YamamotoWorksDev/STM32H7S3_Dev_Board_v2/JUMBLEQ_mainboard_revD_review.md

# JUMBLEQ メインボード rev.D 回路図レビュー

レビュー日：2026-10-27

レビュワー：Codex

## レビュー対象と方法

- `JUMBLEQ_mainboard_revD_design.md`
- `STM32H7S3_Dev_Board.kicad_sch` および階層シート `mcu.kicad_sch`、`dsp.kicad_sch`、`power.kicad_sch`、`usb.kicad_sch`
- KiCadから出力したネットリストと設計書の照合、ERC、関連データシートの確認

回路図・設計書の修正は行っていない。本書はレビュー結果であり、Implementation Planではない。

## 指摘事項

### 1. ［重要］過電圧遮断設定が後段部品の絶対最大定格を超えている

**対象：** `power.kicad_sch` のU12（TPS2121）、R34～R37、および `usb.kicad_sch` のU13（STMPS2141STR）。

OV1・OV2の分圧抵抗23.7kΩ／4.99kΩは、標準しきい値1.06Vに対して約6.09Vで遮断する設定になっている。一方、5V_SYSに直結するU13の入力は、推奨動作上限5.5V、絶対最大6.0Vである。

標準値だけでも遮断前に絶対最大定格へ達し、さらにTPS2121のしきい値と抵抗のばらつきが加わるため、この設定ではU13の過電圧保護を保証できない。

**対応方針：** 正常な5V電源の最大電圧、しきい値・抵抗の誤差、遮断応答中の過渡電圧を含めてOV1・OV2を再設定する。許容範囲が成立しない場合は、後段部品または保護方式を見直す。

**根拠：** [TPS2121データシート](https://www.ti.com/lit/ds/symlink/tps2121.pdf)、[STMPS2141データシート](https://www.st.com/resource/en/datasheet/stmps2151.pdf)。

### 2. ［重要］ホスト側VBUSに明示的な放電経路がない

**対象：** `usb.kicad_sch` のJ10、U13、C82・C83、HOST_VBUS。

HOST_VBUSには10µFのC82・C83（合計20µF）が接続されているが、放電抵抗や放電スイッチは見当たらない。STMPS2141のデータシートにも出力放電機能の記載がない。

機器を抜いてU13をオフにしても、残留電圧の低下を漏れ電流だけに依存する構成になっている。Type-CのSourceに要求される、切断後650ms以内のvSafe0V到達を保証できない。

**対応方針：** 放電抵抗、制御可能な放電回路、または出力放電機能を持つスイッチを検討する。容量・抵抗の誤差と接続負荷を含めて放電時間を確認し、実機では無負荷での切断・再接続時のVBUS波形を測定する。

**根拠：** [USB Type-C Cable and Connector Specification Release 2.4、Table 4-32（TI掲載）](https://e2e.ti.com/cfs-file/__key/communityserver-discussions-components-files/196/USB-Type_2D00_C-Spec-R2.4-_2D00_-October-2024.pdf)、[STMPS2141データシート](https://www.st.com/resource/en/datasheet/stmps2151.pdf)。

### 3. ［重要］TVSのクランプ電圧がTPS2121の絶対最大定格を上回る

**対象：** `usb.kicad_sch` のD9（SMAJ15A）、`power.kicad_sch` のU12、および設計書の「J7の入力保護」。

設計書に記載されたSMAJ15Aのクランプ電圧24.4Vは、TPS2121のIN1の絶対最大定格24Vを上回る。「ほぼ同じ」という理由では保護成立とは判断できず、配線による電圧上昇も考慮する必要がある。

TPS2121のOV1は後段への通電を止める機能であり、IN1端子自体に加わる過電圧を遮断するものではない。また、継続的な誤電圧入力では、TVSの許容損失・エネルギーも問題になる。

**対応方針：** 想定するサージ波形・電流と入力電源の条件を定義し、TVSのクランプ特性、配線、必要に応じた電流制限・遮断手段を含めて保護協調を見直す。継続的な誤電圧と短時間のサージは別々に確認する。

**根拠：** 設計書記載のSMAJ15A仕様、および [TPS2121データシートの絶対最大定格](https://www.ti.com/lit/ds/symlink/tps2121.pdf)。

### 4. ［要修正］bMaxPowerへ本体とコントローラーの合計電流をそのまま設定できない

**対象：** 設計書の「USBホストポート」末尾にあるbMaxPowerの方針。

設計書の想定では、本体300mA＋コントローラー500mA＝800mAになる。一方、USB 2.0のbMaxPowerは2mA単位の1バイトであり、800mAは表現できない。USB HS接続であっても、この点はUSB 2.0である。

**対応方針：** Type-CのCCで得られる1.5A／3Aの給電許可と、USB構成記述子による申告を分けて設計する。Default電源時は、実際に許可された電流から本体の消費分を差し引き、ホスト側給電の可否を判断する。記述子と給電制御の具体的な扱いは、採用するUSBスタックと適用規格に合わせて確定する。

**根拠：** [USBデバイス記述子の仕様例（EPSON技術マニュアル）](https://global.epson.com/products_and_drivers/semicon/pdf/id002129.pdf)。

## 設計書と回路図の不整合

| 対象 | 指摘 | 対応方針 |
| --- | --- | --- |
| 「ファームウェアへの影響」の「アプリ側はGPIOを変更する必要がない」 | SPI5をPM11～PM14からPF6～PF9へ移す方針と矛盾する | SPI5のGPIO初期化変更が必要なことを明記する |
| 「J7の入力保護」のQ4ゲート保護 | 設計書は保護用ツェナーを設けるとしているが、回路図にはR30だけでツェナーがない | ツェナーを追加するか、不要と判断した条件・根拠を設計書へ反映する。通常の5V動作だけを理由に故障と断定する指摘ではない |
| 冒頭の「外部コネクタの信号・ピン機能とも変更なし」 | J1の9番ピンはGNDからPA4へ変更されている | 互換性の例外を明記する。既存キャリアが9番ピンをGNDへ接続している場合、PA4もGNDへ固定されるため、接続先を確認する |

## 確認できた事項

- KiCad ERCを再実行し、エラー0件・警告9件だった。電源保護や放電時間など、上記指摘の成立性はERCでは確認できない。
- FLASH・PSRAMの信号接続は、設計書のXSPI1／XSPI2割当表と出力ネットリストで一致した。
- PSRAM U11のCE#はA3へ接続されていた。

## 未検証事項

- カスタムフットプリントの実寸・ランドパターン照合。
- PCBのBGA引き出し、XSPI配線、インピーダンス、リターンパス、電源・GND配置。
- レギュレータ、Q1、Q4などの実際の放熱性能。
- 全FLASH候補の互換性、電源シーケンス、高速動作。
- 実機でのUSB接続、放電、電源切替、PR_Swap、消費電流・温度測定。

本レビューは回路図接続と関連仕様の確認であり、製造・実機動作の承認を意味しない。

## 再レビュー（2026-10-27）

前回指摘を受けた設計修正について、初回レビュー時と修正後のネットリスト・部品値の差分、設計書の対応内容、変更に直接関係するデータシートを確認した。回路図・設計書の修正は行っていない。

前回の指摘は概ね反映されているが、5V_SYS側の過電圧保護には以下の残件がある。初回レビュー本文は履歴として保持し、修正後の状態は本節を参照する。

### 残件：［要修正］U14の過電圧を「瞬間だけ」とする根拠が成立していない

**対象：** 設計書「レビュー対応」の過電圧遮断に関する説明、および5V_SYSに接続されるU14（USBLC6-4SC6）・レギュレータ・J8。

設計書は、USBLC6-4SC6について「過電圧の瞬間に少し導通するだけで、TPS2121がすぐに遮断する」としている。しかし、TPS2121の遮断電圧が最大6.18Vになる個体では、例えば入力6.1Vが継続しても遮断されず、5V_SYS上のU14にも継続して加わる可能性がある。

USBLC6-4SC6のVBUS–GND間の降伏電圧は最小6V（試験電流1mA）である。したがって、その導通を短時間に限定できるという説明では保護成立を保証できない。これは必ず故障するという断定ではなく、現状の説明と仕様から連続印加時の安全性を確認できないという指摘である。

また、AP7361Cは入力の絶対最大定格が6.5Vでも、推奨動作上限は6.0Vである。6.18Vが絶対最大定格内であることだけでは、その状態での正常な電源出力を保証できない。

**対応方針：** U14とレギュレータ、J8の接続先を含め、5V_SYSに継続して現れ得る最大電圧に対する許容条件を確認する。必要に応じて、過電圧の遮断・クランプ構成または後段部品を見直す。遮断しきい値付近の継続入力と、過渡的な入力を分けて評価する。

**根拠：** [USBLC6-4SC6データシート Table 2](https://www.st.com/resource/en/datasheet/usblc6-4.pdf)、[AP7361Cデータシートの絶対最大定格・推奨動作条件](https://www.diodes.com/datasheet/download/AP7361C.pdf)。

### 前回指摘の対応状況

| 項目 | 再レビュー結果 |
| --- | --- |
| U13の過電圧耐性 | STMPS2141STRからTPS25200DRVRへの変更を確認。1=OUT、2=ILIM、3=FAULT、4=EN、5=GND、6=IN、7=GNDの接続を確認した。ただし5V_SYS全体の保護成立は上記残件の確認が必要 |
| U13の制御・電流制限 | ENのR33による10kΩプルダウン、FAULTのR44による3V3へのプルアップ、ILIMのR45（169kΩ）接続を確認 |
| ホスト側VBUSの放電 | TPS25200の内蔵放電機能で対応する方針は妥当。データシートの放電抵抗は標準480Ω、最大625Ω。実機での無負荷切断・再接続時のVBUS波形確認は必要 |
| TVSのクランプ電圧 | D9のSMAJ15AからSMAJ13Aへの変更を確認。想定するサージ条件での電圧・エネルギーと配線による上振れの確認は引き続き必要 |
| bMaxPower | 800mA相当の合計値をそのまま申告する説明が、500mAの申告とType-C電流通知による給電判断へ修正されていることを確認。USBスタック側の具体的な実装確認は未実施 |
| SPI5・J1の説明 | SPI5のGPIO変更、およびJ1の9番ピンの変更と既存キャリア接続時の注意が追記されたことを確認 |
| Q4ゲート保護の説明 | ツェナーを付けない設計意図が追記されたことを確認。想定サージにおけるTVSの保護成立確認は別途必要 |
| ERC | 修正後の回路図で再実行し、エラー0件・警告9件 |

TPS25200のピン配置・EN極性・放電機能は、[TIデータシート](https://www.ti.com/lit/ds/symlink/tps25200.pdf)で確認した。

### 製作前の確認事項と記載の更新漏れ

- **U13のフットプリント：** 割当済みのKiCad標準フットプリントの端子パッドは0.375×0.4mmで、TIのDRV0006A推奨ランド例の0.45×0.3mmと異なる。直ちに不適合とは断定しないが、端子位置・重なり、露出パッド、はんだマスク・ペーストを含めて照合する。設計書でも未照合事項として残されている。[TIランドパターン](https://www.ti.com/lit/ds/symlink/tps25200.pdf)
- **J8の接続先：** キャリア基板の部品の耐圧確認が未完了。5V_SYS側の保護評価に含める。別プロジェクトの変更は実施していない。
- **R33の説明：** 設計書「回路図作成での確定事項」の「R33（ENのプルアップ）」は、現在の回路に合わせて「プルダウン」へ修正する。
- **U5の型番：** 回路図上のU5はAP7361EA-33E-13、U6はAP7361C-18E-13であり、レビュー対応欄の「U5／U6（AP7361C）」と一致しない。使用する実部品の型番と説明を揃え、その型番の定格で確認する。

今回の再レビューは変更箇所と直接関連する範囲に限定した。PCBの実装・配線、実機の電源波形、温度、USB動作は未検証である。

## PCBレビュー：XSPI・USBの本配線（2026-10-28）

### 対象・確認方法

- 設計書 `JUMBLEQ_mainboard_revD_design.md` の「XSPI・USBの本配線」。確認した版の更新日時は2026-10-28 17:39:01。
- `STM32H7S3_Dev_Board.kicad_pcb`。確認した版の更新日時は2026-10-28 17:37:38。
- 配線・ビア・ネットクラス・カスタムルール、および本配線に伴うコンデンサと電源面の変更。
- 直前のBGA引き出し段階のバックアップとの比較、PCBからの経路・寸法の取得、KiCad DRCと回路図との整合性確認。
- 一時コピーでKiCadのゾーン塗りつぶしを実施し、電源面への接続とDRCを再確認。元のPCB・回路図・設計書は変更していない。

本節は会話で実施した本配線レビューと、その後のスクリーンショットに対する追加確認をまとめたもの。下記は確認時点の指摘であり、修正済みかどうかは修正後のPCBで再確認する。上の回路図レビューは過去の履歴として保持する。

### 総合判断

XSPI・USBデータ線の接続を確認し、新たな短絡・クリアランス違反は検出されなかった。XSPIの細線区間も前回の引き出し段階から短縮されている。

ただし、USBのインピーダンス条件の確認と、XSPIの鋭角の折り返しの修正が必要。本配線を確定する前に以下を反映し、長さ・間隔・ゾーン塗りつぶし後の接続を再確認する。

### 1. ［P2・要確認／修正］USB HSのコネクタ側にrev.Cの配線寸法が残っている

**対象：** U9（ECMF2-40A100N6）～J9、`/USB/D+`・`/USB/D-`。設計書のUSB HSの説明。

U2～U9は今回の寸法で配線されているが、U9～J9の表層約2.7mmには、幅0.2111mm・間隔約0.189mmの配線が残る。J9のA/B面のデータ端子を接続する内層配線にも、幅0.25mmなどの寸法が残っている。

rev.Dで計算したL1の90Ω差動条件は幅0.1753mm・間隔0.2032mmである。積層をJLC06161H-7628からJLC06161H-2116Aへ変更したため、rev.Cの配線を流用したことだけでは、rev.Dでのインピーダンスを確認したことにならない。

これは、その区間が必ず規格外になる、または通信不良になると断定する指摘ではない。実際の形状に対する計算と、許容範囲の確認が不足している。

**対応方針：** U9～J9を含む経路全体について、実際の層・線幅・間隔・参照面を今回の積層で再評価する。通常の並走区間は今回の90Ω条件へ合わせ、コネクタの引き出し・A/B端子の合流部分に生じる寸法の変化は短くする。評価結果と採用寸法を設計書に記載する。

### 2. ［P2・要確認／修正］USB FSを離して配線する条件が未評価

**対象：** U2～U14・J10、`/MCU/USB_FS_D+`・`/MCU/USB_FS_D-`。設計書の「12Mbpsのため、結合した差動にはしていません」の説明。

表層の約21mmの区間で、D+とD-の中心間隔が約3mmある。線幅は0.175mmだが、これは間隔0.2032mmと組み合わせて求めた差動配線の値であり、線幅だけを同じにしても90Ωの条件は維持されない。

Full Speedが12Mbpsであることだけでは、差動インピーダンスの設計目標を外す根拠にならない。ただし、離して配線すること自体を一律に不適合と断定するものではなく、弱く結合した線路としてのインピーダンス、許容範囲、経路の評価が必要である。

**対応方針：** 基本は、今回の積層で計算した90Ωの差動ペアとして配線し直す。離して配線する方針を維持する場合は、その形状での評価と許容判断の根拠を設計書に残す。長さの差だけで合否を判断しない。

### 3. ［P2・要修正］XSPIの3か所に内角45度の折り返しがある

**対象：** 以下の配線。座標はKiCad基板座標、単位mm。

| ネット | 層 | 折り返しの頂点（x, y） | 確認内容 |
| --- | --- | --- | --- |
| PSRAM_IO6 | F.Cu | (127.75, 82.50) | U11のE2付近。内角45度の折り返し |
| FLASH_IO7 | F.Cu | (123.55, 100.25) | U1のE1からの経路。内角45度の折り返し |
| FLASH_IO3 | In2.Cu | (121.80, 92.75) | 同様の内角45度の折り返し |

問題は線が45度以外の方向に伸びていることではなく、経路が大きく折り返して鋭いくさび状の隙間を作ることである。水平・垂直・45度の線だけでも、この形状は生じる。

製造できない、または必ず断線すると断定するものではないが、鋭角部はエッチング時の過剰な侵食などの要因となるため避ける。信号品質についても、局所的なインピーダンス変化や近接部分同士の結合を増やす不要な形状である。実際の影響量は未測定。

**対応方針：** 鋭い折り返しをなくし、通常の45度曲がり（内角135度）や緩やかな経路へ変更する。長さ合わせのための迂回も含むため、単純に近道へ変更して完了にせず、必要な長さは余裕のある場所で間隔を確保した蛇行に置き換える。修正後はデータ群の長さの差を再確認する。

**追加確認による訂正：** 当初の本配線レビューでは、この3か所の折り返しを見落としていた。スクリーンショットの提示を受けてボード上で確認し、追加指摘とした。以前の「45度以外の方向の直線は角度だけを理由に描き直す必要はない」という判断とは区別する。

### 4. ［改善推奨］USB HS D+の細かい直角ミアンダを整理する

**対象：** `/MCU/USB_HS_D+`、F.Cu、x約130.9701～131.2115、y約103.50～104.55。

線幅は0.175mm、蛇行の隣り合う部分の中心間隔は0.35mmで、銅箔間の隙間は約0.175mmある。直角だけを理由に製造不良や通信不良になるとは判断しない。前項の内角45度の鋭角とは区別する。

ただし、細かい蛇行によってD-との間隔が局所的に変化し、蛇行した配線の部分同士も近接している。配線長の増加量が、そのまま電気的な遅延の増加になるとは限らない。現在のミアンダで追加している中心線の長さは約0.97mmである。

**対応方針：** 必要なスキュー補正量を確認し、45度の斜線や円弧を使った余裕のある形状へ整理する。長さの完全一致だけを目的に細かく刻まない。角を変更するだけでなく、差動ペアの間隔と、蛇行の近接部分同士の間隔も確認する。形状変更後に長さとDRCを再確認する。

### 5. ［改善推奨］U1の100nFコンデンサの近接配置を再検討する

**対象：** U1の1V8用C4・C21、およびC3・C20の移動。

U1～U2の配線経路を確保するため、C3・C4・C20・C21はU1の北側の裏面へ移動している。従来の担当ボールから100nFコンデンサの電源パッドまでの平面上の直線距離は、E4～C4で約4.8mm、D1～C21で約7.3mmになった。これらは実際の電流経路やループ長の測定値ではない。

ゾーン塗りつぶし後に電源面への接続は確認できたが、接続の有無だけで高周波のデカップリング性能を確認したことにはならない。

**対応方針：** 4.7µFのバルクとは分けて、100nFのC4・C21だけでも担当電源ボールの近くへ戻せる配置を検討する。位置だけでなく、電源・GNDの両方の経路を短く保つ。

### 6. ［改善推奨］U14・R44のパッド端を通る配線を整理する

**追記日：** 2026-10-28。ユーザーが緑線で囲ったスクリーンショットと、同じ版のPCBを照合した。

**対象：** U14（USBLC6-4SC6）の1・3番パッド、およびR44（10kΩ、0201サイズ）の2番パッド。いずれもF.Cu。

| 箇所 | 確認した形状 | 対応方針 |
| --- | --- | --- |
| U14・1番：USB_FS_D+ | 幅0.175mmの配線がパッドの上辺に沿って通過する | 辺へ直角に接続して十分に重ね、曲がりはパッドとマスク開口から離れた位置に設ける |
| U14・3番：USB_FS_D- | 幅0.175mmの配線が左上の角付近から斜めにパッドを横切る | 基本は辺へ直角に接続する。斜め接続が必要なら、角の方向から十分に重ね、鋭い隙間を残さない |
| R44・2番：HOST_VBUS_FLT | 幅0.18mmの配線がパッドの右上部分をかすめて通過する | 主配線から短く分岐するなどして辺へ直角に接続し、両端の熱バランスも確認する |

現在も配線とパッドの銅箔は重なっており、パッドそのものが欠けているわけではない。斜めに入っていることだけを理由に、はんだ不良が生じるとは断定しない。製造前に整理したい接続形状の改善事項として扱う。

**接続方針の補足・訂正（2026-10-28）：**

PSRAM_CSのパッドへ辺の途中から斜めに接続した追加スクリーンショットを受け、接続方針を以下のように明確化する。従来の「パッド中央付近へ接続する」という説明だけでは、斜めの線をそのまま辺の中央へ入れる形状を勧めるように読めるため不十分だった。上表もこの方針に合わせて更新した。

1. **基本は辺へ直角に接続する。** パッド付近に短い直線部分を設け、パッドとマスク開口から離れた位置で45度に曲げる。接続・引き出しの両方に適用する。
2. **斜めのまま接続する必要がある場合は、辺の途中に鋭角を作るより、角の方向から入れて十分に重ねる。** 角をかすめるだけの接触や細い接続部分を避け、銅箔の輪郭に鋭いくさび状の隙間を残さない。丸みのあるパッドも、実際の銅箔形状で確認する。
3. **小型2端子部品は両端の条件を確認する。** 進入方向だけでなく、配線幅・本数・接続銅箔量・ビアとの距離を比較する。

角からの接続を選ぶ理由は、鋭角をなくすための形状上の改善である。角から接続すれば実装不良を防げる、という一律の保証ではない。

また、基板製造時のエッチング液の残留と、実装時のフラックス・はんだの挙動は別の現象として評価する。鋭角部のエッチング上の懸念と、チップ立ちにつながる両端の加熱・ぬれの不均衡を混同しない。「角度の小さい側に液が残ることがチップ立ちの直接原因である」とまでは、画像や導通確認から断定できない。

**実装品質での確認事項：**

- 銅箔の表示に加え、はんだマスクの開口とペーストの開口を確認する。マスク開口によって接続配線まで露出すると、はんだが配線側へ広がる可能性がある。隣接パッドとのマスクの仕切りも含めて確認する。
- R44は小型の2端子部品であるため、反対側の3V3配線も完成した段階で、両端の配線幅・銅箔量・ビアへの接続を比較する。チップ立ちの主な確認対象は両端の加熱・ぬれの不均衡であり、斜め配線そのものを原因と断定しない。3V3側は今回の確認時点では未配線のため、最終的な熱バランスは未評価。
- U14はESD保護部品なので、信号線から保護端子までの接続を短く保つ。形状を整えるために長い分岐配線を追加しない。GNDへの接続も短くする。

**修正後の確認：** 辺への進入角度とパッド内への十分な銅箔の重なり、鋭いくさび状の隙間の有無、マスク・ペーストの開口、隣接導体との間隔、USB FSの経路と長さを確認し、DRCを再実行する。既存の導通・クリアランス確認だけで、実装時のはんだ形状や熱バランスまで検証済みとはしない。

### 設計書の記載修正

- PSRAM_IO3にはビアが4個ある。「PSRAMのデータは、ほぼIn2だけで配線しました（ビアは両端に1個ずつ）」には、この例外と実際の経路を追記する。
- USBの流用区間とFSの配線方針は、上記の評価・修正結果を反映する。
- 鋭角部やミアンダを変更した後は、長さの集計表も更新する。

### 確認できた事項

| 項目 | 確認結果 |
| --- | --- |
| XSPI・USBデータ線 | 未接続なし |
| XSPIのデータ群の長さの差 | 独立した経路集計でもPSRAM約4.7mm、FLASH約9.3mmで、設計書の設定範囲内。集計方法による小差を含む概数 |
| XSPIの幅0.10mmの区間 | 最長約1.77mmまで短縮。前回の引き出し段階の最長約7.47mmから改善 |
| USB HSのU2～U9 | D+・D-とも約28.70mm |
| 保存済みPCBのDRC | 違反450件＋未配線489件＝939件。回路図との不一致0件 |
| 一時コピーでのゾーン塗りつぶし後 | 違反372件＋未配線358件＝730件。片側だけにつながるビアの警告79件が解消 |
| BGAの電源 | 塗りつぶし後、U2・U1・U11・U10の電源・GNDについて未接続は検出されなかった |
| 新たな短絡・クリアランス違反 | 検出されなかった |

塗りつぶし後の違反372件の内訳は、シルク関係288件、XSPI・USB以外の引き出しの開放端75件、既存のJ9・J10の穴クリアランス4件、既存のライブラリとの不一致4件、DSP用DVDD面の孤立銅箔1件。DSP用DVDD面は今回の信号配線とは別の残件である。

上記の接続・長さ・DRCの結果は、角度やインピーダンスなどの指摘を解消したことを意味しない。また、後続の配線や配置変更に伴い、再確認が必要となる。

### 修正後の確認事項

1. XSPIの鋭角3か所を修正し、データ群の長さの差を再集計する。
2. USB HSをU2～U9～J9の全経路で確認し、流用区間のインピーダンス条件を更新する。
3. USB FSの配線形状とインピーダンス条件を整合させる。
4. USB HSのミアンダ、U1の100nFコンデンサの改善を検討し、採用した形状・配置を設計書へ反映する。
5. U14の1・3番とR44の2番のパッド接続形状を、辺へ直角に接続することを基本として整理する。追加画像のPSRAM_CSも同じ方針を適用し、斜め接続時には鋭角を残さない。マスク・ペーストの開口、および小型2端子部品の両端の配線後の熱バランスも確認する。
6. ゾーンを塗りつぶしてDRCと回路図との整合性を再確認する。残りの配線を進めても、GND参照面と電源面の接続を維持する。

実機でのUSB通信、XSPI 200MHz DDR動作、信号波形・アイパターン、電源品質は未検証。電磁界解析や信号品質シミュレーションは実施していない。本節は今回の配線範囲のレビューであり、製造データや実機動作の承認ではない。

### 根拠資料

- [ST AN5935：Getting started with STM32H7Rx/7Sx MCUs hardware development](https://www.st.com/resource/en/application_note/an5935-getting-started-with-stm32h7rx7sx-mcus-hardware-development-stmicroelectronics.pdf)：10.4.3のXSPI配線条件。
- [JLCPCB Impedance Calculator公式ガイド](https://jlcpcb.com/help/article/user-guide-to-the-jlcpcb-impedance-calculator)：積層・線幅・間隔・参照面を組み合わせた計算条件。
- [TI SLLA414A：High-Speed Layout Guidelines for Signal Conditioners and USB Hubs](https://www.ti.com/lit/an/slla414a/slla414a.pdf)：USB 2.0のインピーダンス目標、差動ペアの対称性、曲がり方。
- [TI SPMA056：System Design Guidelines for the TM4C129x Family](https://www.ti.com/lit/an/spma056/spma056.pdf)：3.3.4の直角配線と鋭角部に関する説明。一般的な配線形状の参考資料として参照。
- [JLCPCB：Basic Design of Solder Mask](https://jlcpcb.com/blog/basic-design-of-solder-mask)：マスク開口と、接続配線に広がるはんだの関係。
- [Eurocircuits：Tombstoning](https://www.eurocircuits.com/technical-guidelines/pcb-assembly-guidelines/tombstoning/)：小型2端子部品の加熱・ぬれの不均衡とチップ立ち。
- [ST USBLC6-4データシート](https://www.st.com/resource/en/datasheet/usblc6-4.pdf)：2.3のESD保護用配線を短くする指針。
- [EMA Design Automation：Top DFM Issues to Check and Avoid During PCB Layout](https://www.ema-eda.com/ema-resources/blog/top-dfm-issues-to-check-and-avoid-during-pcb-layout/)：鋭角部とエッチング時の液残留に関する説明。実装時のチップ立ちとは分けて参照。

## 追加レビュー：U10のパッド内ビアと配線端点（2026-10-29）

対象は、追加画像と保存済みPCB（更新日時：2026-10-28 20:16:16）のU10周辺。前回レビューではU10のパッド内ビアを見落としていたため、追加の修正事項として記録する。U10は現在DNPだが、実装オプションとして使用する場合の製造・実装条件を整える必要がある。

### 1. 要修正：U10の5か所のパッド内ビア（U10実装時）

U10は裏面のSOIC-8で、FLASH_IO0/1に加え、FLASH_CS、GND、1V8にもパッド内ビアがある。該当ビアはいずれも外径0.45mm、穴径0.20mm。以下の座標はPCB上の絶対座標で、単位はmm。

| ピン | ネット | パッド中心（X, Y） | ビア中心（X, Y） |
| --- | --- | --- | --- |
| 1 | FLASH_CS | 120.405, 100.5875 | 120.4, 100.1 |
| 2 | FLASH_IO1 | 119.135, 100.5875 | 119.4, 99.9 |
| 4 | GND | 116.595, 100.5875 | 116.6, 100.6 |
| 5 | FLASH_IO0 | 116.595, 93.4125 | 116.9, 93.6 |
| 8 | 1V8 | 120.405, 93.4125 | 120.4, 93.4 |

FLASH_IO0/1は特にパッドの側端近くにビアがあり、穴がパッドの開口に重なる形状になっている。実装時には、はんだがビア穴へ吸い込まれ、端子下のはんだ量が不足する懸念がある。ここで主に確認すべき不良はSOIC端子のはんだ不足・接合不良であり、小型2端子部品のチップ立ちとは区別する。

現行PCBの設定は表裏の通常のテンティングが有効で、充填・銅キャップの指定はない。発注時の加工条件は未確認であり、PCBの設定だけではFilled & Cappedによる平坦な実装面を保証できない。通常のテンティングだけでパッド内ビアの問題が解消したとは判断しない。

修正方針は次のいずれかとする。

- ビアをパッド外へ移し、実際のソルダーマスク開口間に分離を確保して、短い配線で接続する。ビア穴がパッドから少し外れるだけでは、開口の重なりが残る可能性がある。
- パッド内ビアを残す場合は、JLCPCBでのFilled & Cappedの適用範囲と加工条件を確定し、製造データおよび発注仕様に反映する。

**ビアをパッド中央へ移すだけでは、はんだの吸い込み対策にならない。** 配線をビア中心へ接続するルールと、実装パッド内にビアを置いてよいかという判断は別に扱う。

### 2. 改善：U10の配線端点をパッド中心へ統一する

3番FLASH_IO2、6番FLASH_CLK、7番FLASH_IO3の裏面配線端点は、パッド中心まで届かず、端部または角付近で止まっている。採用済みの配線ルールに合わせ、端点をパッド中心へそろえる。辺から入る場合は直角に接続し、斜めに入る場合は角から接続して鋭角のくぼみを残さない。

ただし、**既に配線の銅箔がパッドへ十分に重なっている場合、パッド内だけ端点を延長しても、製造される銅箔形状は通常変わらない。** 「中心まで届いていない」ことだけを断線や実装不良の根拠にはしない。実装品質については、パッド外の接続形状、ビア穴、ソルダーマスク・ペースト開口を確認する。

### 修正後の確認事項

1. 1・2・4・5・8番のビアについて、パッド外への移動とマスク開口の分離、またはFilled & Cappedの製造条件確定を確認する。
2. 3・6・7番を含むU10の配線端点と、パッドへの進入形状を確認する。ビアへの配線はビア中心へ接続し、パッド外に直角の折れ曲がりや鋭角のくぼみを残さない。
3. U1/U10の排他実装構成、XSPIの配線長・分岐長・参照面を維持し、ビア移動による不要な引き回し増加を避ける。
4. ゾーンを再充填してDRCを確認し、製造データで実装面のパッド開口・ビア穴・マスク分離を確認する。U10を実装する場合は、試作時のはんだ接合状態も確認する。

今回の追記ではPCBデータを変更しておらず、DRCも再実行していない。過去の節に記載したDRC件数は、それぞれの確認時点の結果として扱う。

### 根拠資料

- [JLCPCB：Via-in-Pad (POFV) Guide](https://jlcpcb.com/help/article/via-in-pad-pofv-guide)：パッド内ビアによるはんだの吸い込みと、充填・キャップ処理。
- [JLCPCB：PCB Via Covering](https://jlcpcb.com/help/article/pcb-via-covering)：テンティングとFilled & Cappedの加工方法の違い。

## PCBレビュー：配線完了後の全体確認（2026-11-05）

レビュワー：Claude

### 対象・確認方法

- `STM32H7S3_Dev_Board.kicad_pcb`。確認した版の更新日時は2026-11-04 21:07:47（KiCadで開いている最中のため、保存済みの版を対象とした）。
- `JUMBLEQ_mainboard_revD_design.md`（更新日時2026-11-04 21:12:34）と、本書の過去の指摘。
- KiCad 10.0.7でDRC・ERC、回路図とフットプリントの照合を実行した。
- PCBファイルから配線・ビア・パッド・ゾーンの塗りつぶし形状を読み出し、次を集計した。
  - 全信号配線の参照GND面（F.Cu・In2→In1、B.Cu→In4）
  - F.Cu／In2とB.Cuの間で層を切り替える箇所から最寄りのGNDビアまでの距離
  - クロック線と隣接配線の間隔・並走長
  - XSPI・USB・SDMMC・SAIの配線長
  - 内角90度未満の鋭角と、配線途中の90度の曲がり
  - パッドとビアの間隔、シルク
- PCB・回路図・設計書は変更していない。長さは特記がない限りビアの層間距離を含まない平面上の中心線長、座標はKiCadの基板座標（mm）である。
- 確認用の図は `.work/review-20261105/` に置いた（`sai_in.png`：SAI 3本の経路、`silk_front.png`：表面シルクと基板直置きのシルク線）。

### 総合判断

未配線は0件で、回路図との不一致もない。DRCに残る175件は、シルク168件、J9・J10の穴クリアランス4件、ライブラリとの差分3件で、短絡やクリアランス違反はない。内層のGND面・電源面は連続しており、信号配線の参照GND面に、アンチパッド以外の切れ目は見つからなかった。XSPI・USB・SDMMCは、設計書の値と条件を満たしている。

一方で、11/04の残配線に伴って、MCU→DSPのSAI（SAI2）が大きく迂回している。また、シルクにrev.Cの表記・枠・ラベルが残っている。製造データを作る前に、下記の1〜4への対応を勧める。

### 1. ［P2・要修正］MCU→DSPのSAI 3本が大きく迂回し、直列抵抗が受信側にある

**対象：** `/DSP/DSP_BCLK_IN0`（U2.P14→R13）、`/DSP/DSP_LRCLK_IN0`（U2.N13→R15）、`/DSP/DSP_SDATA_IN0`（U2.M12→R18）。

| 信号 | U2→直列抵抗の長さ | 信号ビア | F.Cu／In2⇔B.Cuの切替（参照面がIn1⇔In4に変わる） | 11/04の変更前（設計書） |
| --- | ---: | ---: | --- | --- |
| BCLK_IN0 | 73.26mm | 8個 | 6か所。うち4か所は最寄りGNDビアまで3.19〜4.46mm | 34.04mm／3個 |
| LRCLK_IN0 | 59.95mm | 5個 | 2か所（最寄りGNDビアまで0.70mm） | 59.95mm／5個 |
| SDATA_IN0 | 70.11mm | 12個 | 8か所。最寄りGNDビアまで0.61〜2.94mm（1mm超が6か所） | 36.83mm／3個 |

3本は、BGAの左上（127〜129, 90〜92付近）から出ている。BCLKはJ2近く（x≈105）まで西へ、SDATAはU11の北（y≈80）を回ってx≈155まで東へ出てから、U3の手前のR13・R15・R18（x≈140.4, y≈108.8〜110.4）へ戻っている（`sai_in.png`）。U2のボールから抵抗までの直線距離は約22mmである。

- **直列抵抗の位置：** R13・R15・R18は、U3のピンから約1.6〜1.9mmの位置にある。SDATA_IN0はMCUのSAI2A\_DATA\_OUTが駆動するので、R18は受信端にあり、ダンピング抵抗として働かない。MCUがSAI2のクロックマスターであれば、BCLK・LRCLKのR13・R15も同じ状態になる。DSP→MCU側のR14・R16・R19は、駆動側のU3の近くにあり、問題ない。
- **長さと配線形状：** 約70mmの線長は、STM32のGPIOを高速設定にしたときの立ち上がり時間に対して、反射を無視できる長さではない。そこに反射・リンギングを抑える抵抗がない状態である。BCLKが1回でも二重にクロックされると、音声データのずれとして現れる。さらにBCLKは、参照面の切替点の近くにGNDビアが少ない。
- **隣接配線：** BCLK_IN0は、裏面のy≈107.4〜107.8・x 110.7〜124.3で、J2向けのI2S3\_SDIと約13.7mm、銅箔間隔0.22mmで並走している。

これは、必ず誤動作すると断定する指摘ではない。反射・クロストークの量は計算・測定していない。ただし11/04の変更でBCLK・SDATAの線長が約2倍、ビアが3〜4倍になっており、DRCでは検出されない劣化である。

**対応方針：**

1. 3本を短い経路へ引き直す。目安は変更前の35mm前後。裏面を通す場合は、F.Cu⇔B.Cuの切替点から1mm程度以内にGNDビアを置く。I2S3\_SDIとの並走は、なくすか、間隔を線幅の3倍以上にする。
2. 経路を大きく変えられない場合は、MCUが駆動する信号の直列抵抗をU2の近くへ移す。SDATA_IN0は必須、BCLK・LRCLKはMCUがマスターの場合に移す。
3. ファームウェアでは、SAI2のGPIO速度を必要最小限（LowまたはMedium）に設定する。
4. 試作では、U3のピン側でBCLK_IN0の波形（オーバーシュート・リンギング・階段状の部分）を確認する。

### 2. ［P2・要修正］シルクにrev.Cの版表記・枠・ラベルが残っている

| 内容 | 位置・状態 |
| --- | --- |
| 版・日付 | 表面に「rev.C」（154.5, 94.8）と「2025/07/02」（148.4, 96.4）が残る |
| 旧配置の枠 | 基板に直接置かれたシルク線148本の多くが、rev.Cの部品配置に合わせた枠（`silk_front.png`の赤線）。U11（PSRAM）のボールパッドD3〜D5・E3・A5の上を横切る線（例：(129.85, 80.25)→(134.4, 80.25)）や、U5・U1・U12周辺と重なる線がある |
| USBコネクタのラベル | J9・J10の間の「MCU」（132.2, 129.1）と「DSP」（138.6, 129.1）、J10下の「USBi」（149.1, 136.1）。rev.DのJ10はMIDIコントローラー用のUSBホストで、DSP（USBi）用ではない |
| DRC | シルク関係168件：パッドとの重なり72件、シルク同士の重なり92件、基板端4件 |

パッドに重なったシルクは、通常は基板メーカーが削るので、はんだ付けへの影響は小さい。ただしβ版を他の人が使う基板で、版表記とコネクタのラベルが実態と違うと、取り違えの原因になる。

**対応方針：**

- 版表記を「rev.D」と発行日に更新する。
- 旧配置の枠を削除するか、現在の配置に合わせて描き直す。
- J9を「PC」「DEVICE」など、J10を「HOST」「MIDI」などに改める。
- そのうえで、シルク関係のDRCを、基板端（コネクタのはみ出し）以外は解消する。

### 3. ［要修正・軽微］11/04の変更で、パッドに近すぎるビアが2か所できている

設計書の配線ルール「実装パッドの中にビアを置かない。新しく置くビアは、パッドの銅箔との間を0.15mm以上空ける」に反する。

| 部品・パッド | ビア（外径／穴径） | 状態 | 経緯 |
| --- | --- | --- | --- |
| C28・2番（1V8、裏面0201） | (128.40, 93.80)、0.45／0.20mm | ビアの銅箔がパッドに約0.05mm重なる（穴はパッドの外） | 11/04にC28を(128.150, 93.085)・270°へ移動 |
| R3・1番（1V8、表面0201） | (112.38, 96.08)、0.60／0.30mm | パッドとの間隔約0.02mm | 11/04にR3を移動し、1V8ビアを移動 |

マスク開口とテンティングの境目にビアがかかり、0201の片側だけにはんだが流れる原因になり得る。ビアをパッドの外へ0.15mm以上離し、短い配線で接続する。

### 4. ［製造前確認］発注仕様・部品の確定

- **表面処理：** PCBの設定は「None」。0.8mmピッチのBGAと0201を実装するので、ENIGを指定する。JLCPCBも、平坦性の点からBGA・狭ピッチ部品にはHASLよりENIGが適しているとしている。
- **フィデューシャル：** 基板上にはない。JLCPCBのStandard PCBAでは、エッジレールとフィデューシャルが必要である。両面実装なので、発注時に表裏とも付けるようにする。基板内に3点置く方法でもよい。
- **J9・J10の穴クリアランス（DRCエラー4件）：** 10/29から未決定のまま。NPTHとGNDパッドの間隔は0.1651mm（設定0.20mm）。フットプリントの調整か、メーカーへの確認で扱いを決める。
- **J7の型番：** 設計書は「S2B-XH-A（横向き）」だが、フットプリントはJST\_XH\_B2B-XH-A\_1x02\_P2.50mm\_Vertical（縦型）。どちらを実装するかを決め、横向きにするならフットプリントと向き（差込口の方向、基板端との関係）を合わせる。
- **U3（ADAU1466）の露出パッド：** 5.3mm角のパッド73自体にペースト層がある。そのため、フットプリント内の窓状のペースト16個（約72%）と合わせて、実質100%の塗布になる。パッド内には0.6／0.3mmのGNDビアが9個あり、穴が開いたままである。U7（TCPP03）の露出パッドも、2.2mm角にビア5個で全面ペーストである。パッド73のペースト層を外して窓状の開口だけにし、ビアを窓の間に置くか穴埋めを指定するかを決める。rev.Cで同じ構成の実績がある場合は、その結果で判断してよい。

### 5. ［改善推奨］クロック・アナログ入力の近接並走

DRCの間隔は満たしているが、次の並走を広げられる場所では広げる。表の間隔は銅箔端の間隔。

| 組み合わせ | 層 | 並走長 | 間隔 | 位置 |
| --- | --- | ---: | ---: | --- |
| CLKOUT（DSP→MCU・J5）とSDATA_OUT2 | In2 | 約7.1mm | 0.133mm | (145.5, 108.8)→(150.5, 113.8)の斜め区間 |
| BCLK_OUT1とLRCLK_OUT2 | In2 | 約4mm | 0.139mm | U3北東、(148.5, 109.4)→(151.0, 112.3)付近 |
| BCLK_OUT2とSDATA_OUT1 | B.Cu | 約2.3mm | 0.139mm | (146.0〜147.4, 108.8〜110.2) |
| ETH_RMII_REF_CLK（50MHz）とADC1_IN0 | In2 | 約6mm | 0.34mm | (140.7, 83.3)→(144.9, 79.1) |
| SDMMC2_CKとADC1_IN18 | In2 | 約3.6mm | 0.169mm | (135.5, 88.7)→(136.8, 85.8)。BGA引き出しの出口 |
| HSE_IN（24MHz）とADC1_IN12 | F.Cu | 約2mm | 0.22mm | (137.6〜139.6, 93.4)。BGA引き出しの出口 |

ADC入力は、入力源とフィルタが未確定である。クロックの結合がADC精度にどれだけ影響するかは、実機で確認する。

### 6. ［改善］配線形状の残り

設計書の配線ルールに対する残りで、電気的な影響は小さい。

- **配線途中の90度の曲がり（8か所）：**
  - LPUART1_RTS（B.Cu）：(114.904, 104.304)、(120.585, 104.8)、(122.28, 104.8)
  - ADC1_IN13（In2）：(136.4, 92.2)
  - ADC2_IN2（F.Cu）：(131.2, 74.9)
  - FDCAN2_RX（In2）：(125.85, 92.65)
  - LPUART1_TX（In2）：(134.15, 101.75)
  - ETH_RMII_CRS_DV（F.Cu）：(154.556, 84.819)
- **内角45度の折り返し：** FDCAN2_RX（In2）の(125.0, 91.8)。(125.85, 92.65)から来て、東へ折り返している。
- **T分岐の45度のくさび：**
  - FLASH_IO1（In2）：(121.55, 98.4)。U10への分岐
  - I2C2_SCL（In2）：(129.2, 101.8)
  - I2C2_SDA（F.Cu）：(124.6, 103.1)
- **重複・微小な配線片：**
  - FLASH_IO1（In2）：(127.6, 96.2)→(127.6, 96.4)が2本重複
  - GND（B.Cu）：(126.92, 92.32)と(128.635, 92.765)の周辺に重複区間
  - CLKOUT（In2）：(150.49〜150.55, 113.8)の0.06mmの折り返し
  - NRST（F.Cu）：(156.748, 134.439)の0.07mmの枝
  - FLASH_IO0（In2）：(118.53, 95.22)の0.01mmの枝

### 7. ［要確認］Q1（FZT953）の放熱

コレクタ（DVDD）の銅箔は、表面約24mm²、裏面約35mm²、In3のDVDD島約145mm²である。タブから裏面・内層へのビアは(153.6, 123.5)と(153.6, 124.3)の2個だけである。設計書の熱抵抗78℃/Wは、25×25mm（625mm²）・1ozの条件の値である。標準的なプログラム（約0.46W）では問題になりにくい。一方、最大負荷の見積もり（約1.04W）では、接合部温度の余裕がない可能性がある。タブの銅箔内に放熱ビアを数個追加し、試作基板でDVDD電流とQ1の温度を測る（設計書の未完了項目と同じ）。

### 前回までの指摘の対応状況

| 指摘 | 現在の状態 |
| --- | --- |
| 回路図1：OV設定 | R34・R36＝21.5kΩをPCBで確認。5.28V付近での誤遮断を許容する方針は設計書どおり |
| 回路図2：ホスト側VBUSの放電 | U13＝TPS25200DRVR、専用フットプリント（DRV0006A）を確認 |
| 回路図3：TVS | D9＝SMAJ13Aを確認 |
| 再レビュー：U14の過電圧 | U14の5番（VBUS）が3V3に接続されていることを確認 |
| 再レビュー：J8の先の耐圧 | 未確認のまま（キャリア側） |
| PCB1：USB HSのU9〜J9 | 0.175mm／間隔約0.203mm、In2は0.164mmで配線し直し済み。U9→J9はA側4.06／4.06mm、B側5.78／5.78mm |
| PCB2：USB FS | ペアとして配線済み。U14周辺の約5mmは非並走（設計書記載どおり）。U2→J10のA6／A7は39.58／39.95mm |
| PCB3：XSPIの鋭角 | XSPIの折り返しは解消。FLASH_IO1のU10分岐に45度のくさびが1か所ある（上記6） |
| PCB4：USB HSのミアンダ | 台形4つへの変更を確認。U2→U9はD+・D−とも28.70mm |
| PCB5：U1の100nF | C4・C21が担当ボールの近くにあることを確認 |
| PCB6：U14・R44のパッド接続 | 設計書の対応内容を確認。形状の詳細は今回再確認していない |
| U10のパッド内ビア | U10のパッドに重なるビアはない |
| C75のDNP不一致 | PCB・回路図とも実装扱いで一致 |

### 確認できた事項

| 項目 | 結果 |
| --- | --- |
| DRC（KiCad 10.0.7） | 175件（シルク168、穴クリアランス4、ライブラリ差分3）。未配線0、回路図との不一致0 |
| ERC | 除外を除き警告9件（rev.Cから引き継いだもの。以前と同じ件数） |
| 回路図とフットプリント | 174個で一致 |
| 内層の面 | In1／In4のGND面、In3の3V3面と各島（1V8・DVDD・5V_SYS・5V_UCPD・5V_IN）は、それぞれ1つの連続した銅箔 |
| 参照GND面 | 信号配線は、ビア・穴のアンチパッド以外では途切れなく参照面の上を通る。U2下でアンチパッド同士がつながった部分を通る区間は、最長0.72mm（I2S3_WS、B.Cu）で、BGA引き出しの範囲内 |
| XSPI | データ群（DQS・IO0〜7）の長さの差：PSRAM 4.12mm、FLASH 6.15mm（ビアの層間距離を加えると設計書の約9.2mm）。CLKの蛇行なし。U10への分岐は、主経路の分岐点から2.0〜5.5mm |
| SDMMC2 | CK・CMD・D0〜D3は設計書の値と一致（58.26〜66.40mm、D0〜D3のビア各4個） |
| USB HS | 主並走区間の銅箔間隔は0.202〜0.215mm |
| パッド内ビア | 露出パッドの放熱ビア（U3・U7・U13）とC28以外にはない |

### 未検証事項

- 反射・クロストーク・PDNの数値解析と、電磁界シミュレーション。
- 実機でのSAI・SDMMC・Ethernet・USB・XSPIの波形とタイミング、ADC精度、Q1・U5・U6の温度。
- J9・J10・J7の実物の寸法と、筐体・キャリアとの干渉。
- 裏面シルクの内容（今回は表面を中心に確認した）。

本節は配線完了時点のPCBのレビューであり、製造データや実機動作の承認ではない。

### 根拠資料

- [JLCPCB：Surface Finish](https://jlcpcb.com/help/article/jlcpcb-surface-finish)：HASLは平坦性が必要なBGAなどに向かず、ENIGが適している。
- [JLCPCB：How to add edge rails/fiducials for PCB assembly order](https://jlcpcb.com/help/article/how-to-add-edge-rails-fiducials-for-pcb-assembly-order)：Standard PCBAではエッジレールとフィデューシャルが必要。
- [ST AN5935](https://www.st.com/resource/en/application_note/an5935-getting-started-with-stm32h7rx7sx-mcus-hardware-development-stmicroelectronics.pdf)：XSPI・SDMMCの配線条件（既存の判断基準として参照）。
- [ADAU1462/1466データシート](https://www.analog.com/media/en/technical-documentation/data-sheets/adau1462-1466.pdf)：露出パッドのGND接続とPCB設計の注意。
