YamamotoWorksDev/STM32H7S3_Dev_Board_v2/STM32H7S3_Dev_Board.kicad_pcb

## KiCad design STM32H7S3_Dev_Board.kicad_pcb (2026-11-12)

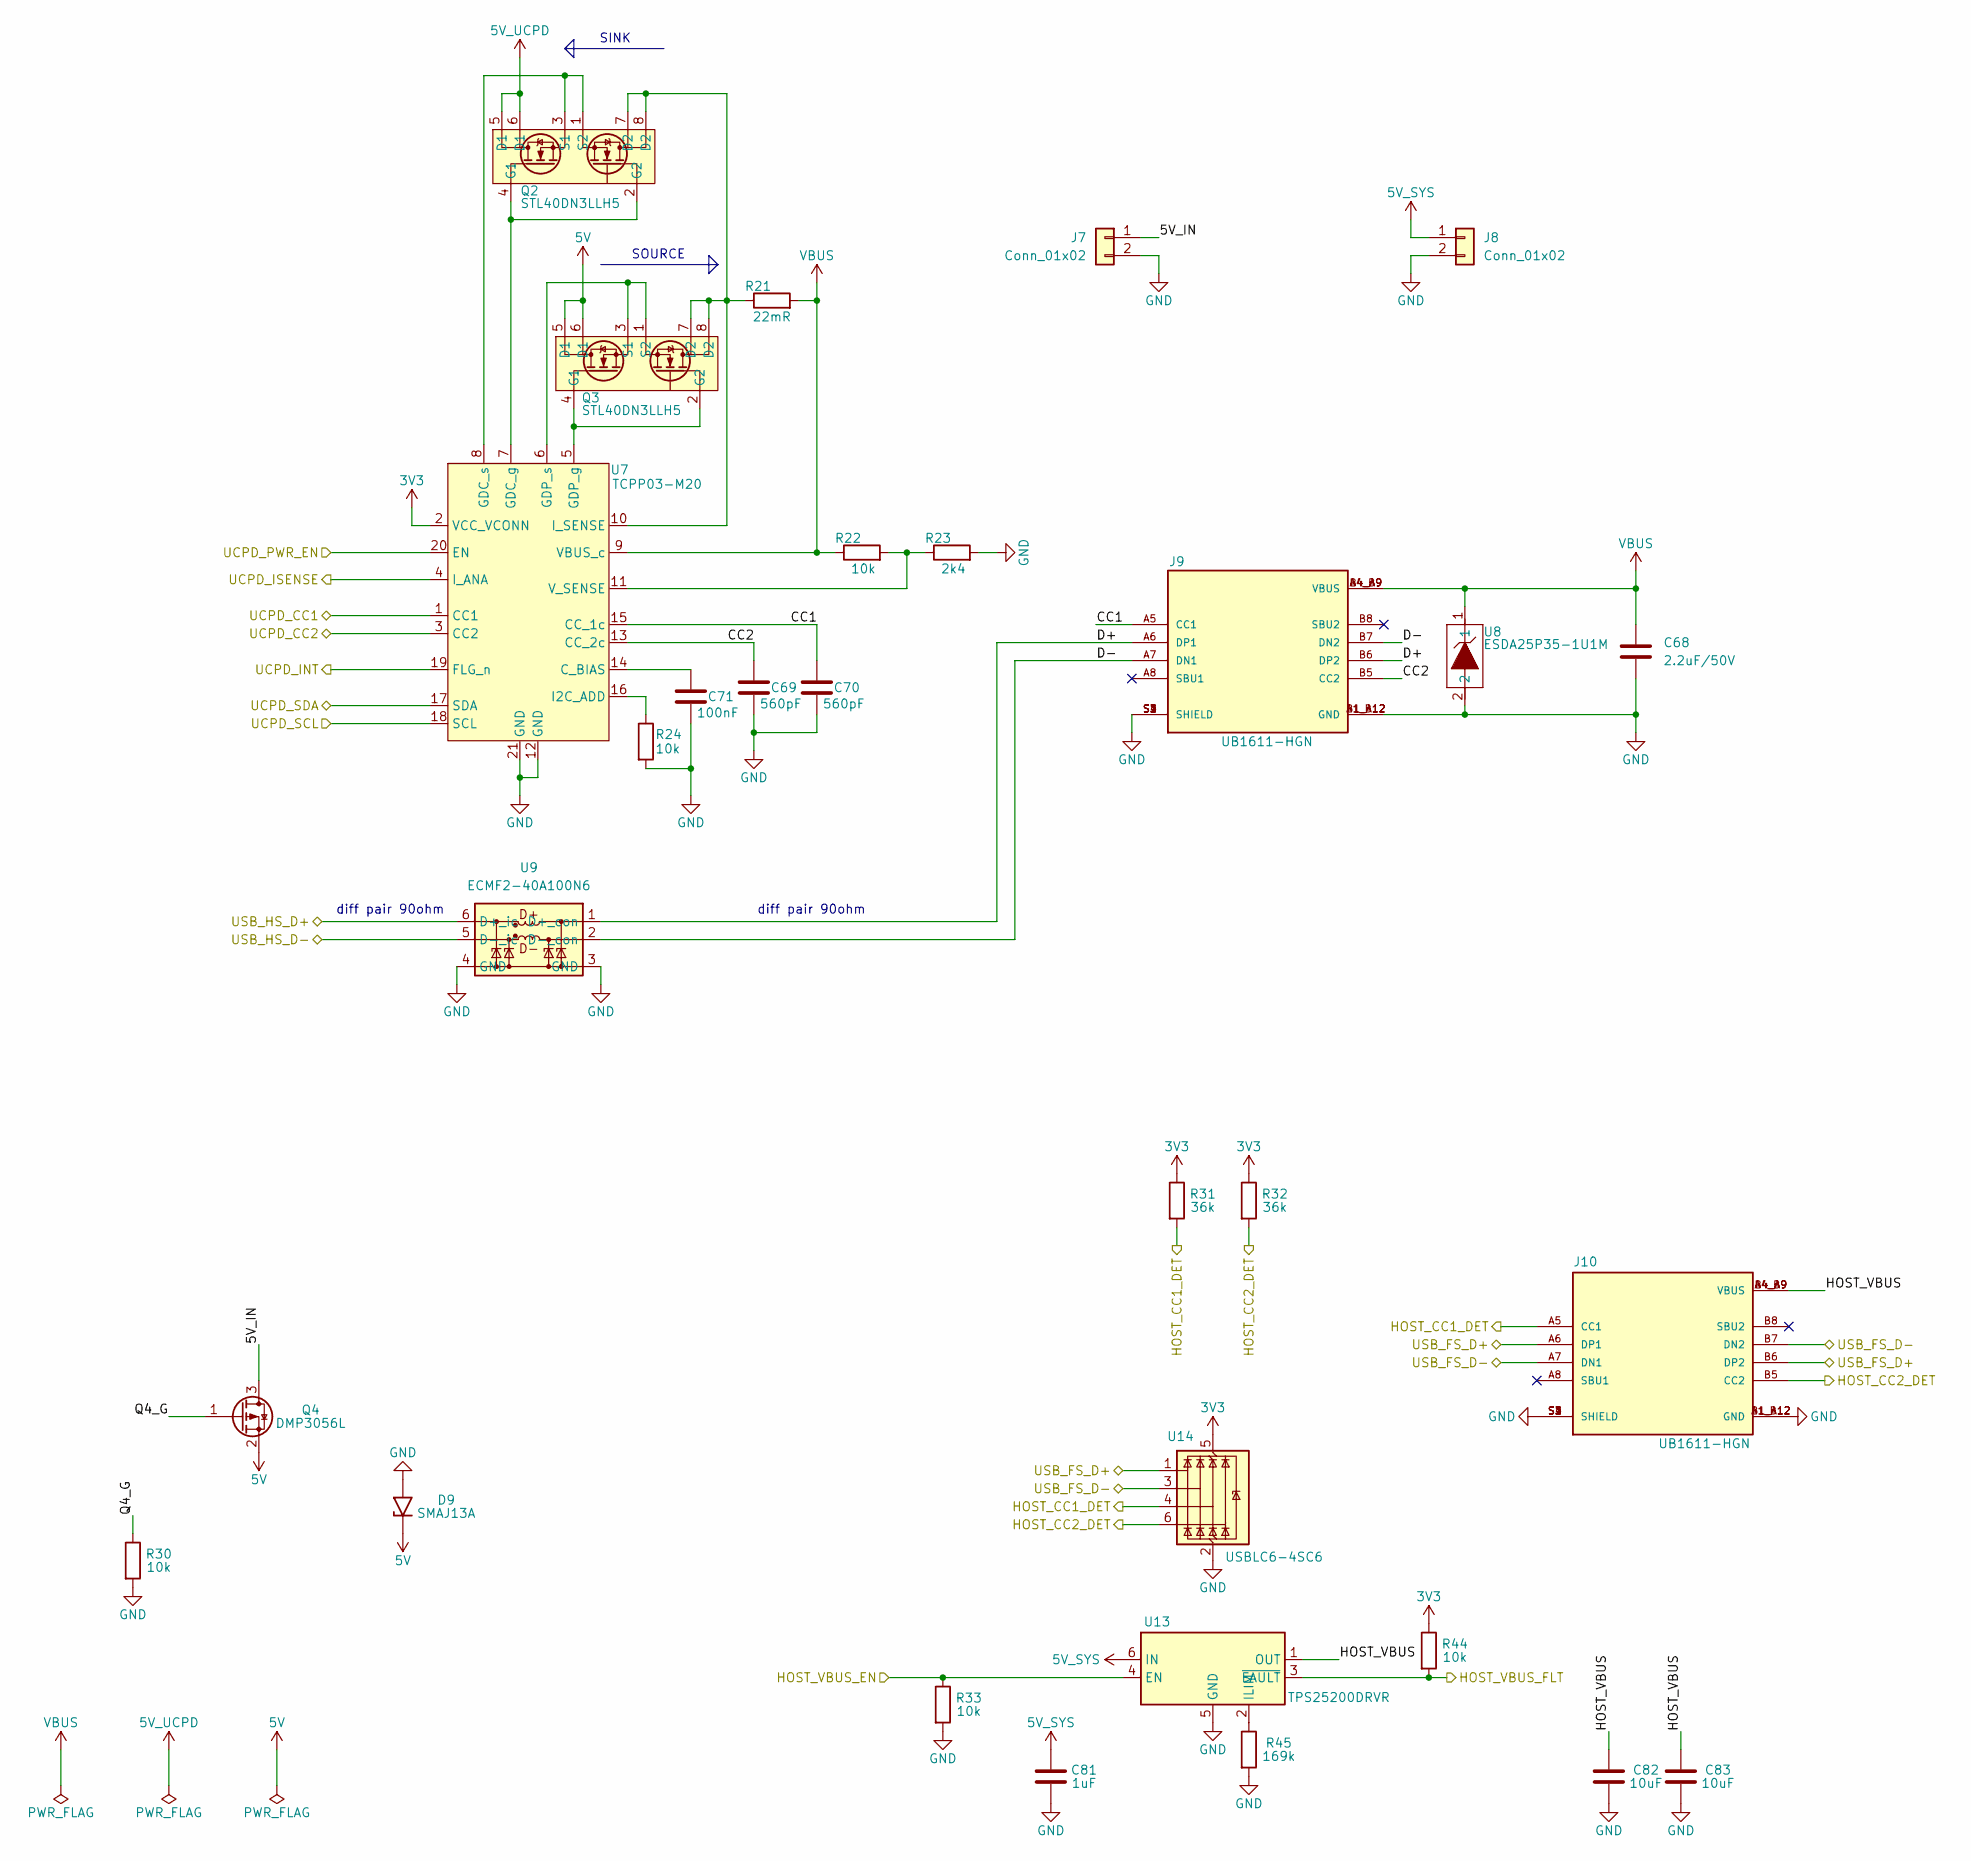
[picture p1: schematic usb.kicad_sch]

Parts:
C68: 2.2uF/50V; C_0603_1608Metric
C69, C70: 560pF; C_0201_0603Metric
C71: 100nF; C_0201_0603Metric
C81: 1uF; C_0402_1005Metric
C82, C83: 10uF; C_0402_1005Metric
D9: SMAJ13A; D_SMA
J7: Conn_01x02; JST_XH_B2B-XH-A_1x02_P2.50mm_Vertical
J8: Conn_01x02; JST_PH_B2B-PH-K_1x02_P2.00mm_Vertical
J9: UB1611-HGN; Gangyuan_UB1611-HGN; PARTREV B
J10: UB1611-HGN; Gangyuan_UB1611-HGN
Q2, Q3: STL40DN3LLH5; SON_DN3LLH5_STM
Q4: DMP3056L; SOT-23
R21: 22mR; R_0603_1608Metric
R22, R24, R30, R33, R44: 10k; R_0201_0603Metric
R23: 2k4; R_0201_0603Metric
R31, R32: 36k; R_0201_0603Metric
R45: 169k; R_0201_0603Metric
U7: TCPP03-M20; QFN-20L_4.0X4.0X0.75_STM
U8: ESDA25P35-1U1M; QFN1610_STM
U9: ECMF2-40A100N6; QFN6L_ECMF2_STM
U13: TPS25200DRVR; TI_DRV0006A_WSON-6-1EP_2x2mm_P0.65mm_EP1x1.6mm
U14: USBLC6-4SC6; SOT-23-6

Connections:
3V3: R31.1, R32.1, R44.1, U7.2 (VCC_VCONN), U14.5 (VBUS); also elsewhere on the board
5V: D9.1 (A1), Q3.5 (D1), Q3.6 (D1), Q4.2 (S); also elsewhere on the board
5V_SYS: C81.1, J8.1, U13.6 (IN); also elsewhere on the board
5V_UCPD: Q2.5 (D1), Q2.6 (D1); also elsewhere on the board
/MCU/HOST_CC1_DET: J10.A5 (CC1), R31.2, U14.4 (I/O3); also elsewhere on the board
/MCU/HOST_CC2_DET: J10.B5 (CC2), R32.2, U14.6 (I/O4); also elsewhere on the board
/MCU/HOST_VBUS_EN: R33.1, U13.4 (EN); also elsewhere on the board
/MCU/HOST_VBUS_FLT: R44.2, U13.3 (~FAULT); also elsewhere on the board
/MCU/I2C2_SCL: U7.18 (SCL); also elsewhere on the board
/MCU/I2C2_SDA: U7.17 (SDA); also elsewhere on the board
/MCU/UCPD_CC1: U7.1 (CC1); also elsewhere on the board
/MCU/UCPD_CC2: U7.3 (CC2); also elsewhere on the board
/MCU/UCPD_INT: U7.19 (FLG_n); also elsewhere on the board
/MCU/UCPD_ISENSE: U7.4 (I_ANA); also elsewhere on the board
/MCU/UCPD_PWR_EN: U7.20 (EN); also elsewhere on the board
/MCU/USB_FS_D+: J10.A6 (DP1), J10.B6 (DP2), U14.1 (I/O1); also elsewhere on the board
/MCU/USB_FS_D-: J10.A7 (DN1), J10.B7 (DN2), U14.3 (I/O2); also elsewhere on the board
/MCU/USB_HS_D+: U9.6 (D+_ic); also elsewhere on the board
/MCU/USB_HS_D-: U9.5 (D-_ic); also elsewhere on the board
/USB/5V_IN: J7.1, Q4.3 (D)
/USB/CC1: C70.1, J9.A5 (CC1), U7.15 (CC_1c)
/USB/CC2: C69.1, J9.B5 (CC2), U7.13 (CC_2c)
/USB/D+: J9.A6 (DP1), J9.B6 (DP2), U9.1 (D+_con)
/USB/D-: J9.A7 (DN1), J9.B7 (DN2), U9.2 (D-_con)
/USB/HOST_VBUS: C82.1, C83.1, J10.A4_B9 (VBUS), J10.B4_A9 (VBUS), U13.1 (OUT)
/USB/Q4_G: Q4.1 (G), R30.1
GND: C68.2, C69.2, C70.2, C71.2, C81.2, C82.2, C83.2, D9.2 (A2), J7.2, J8.2, J9.A1_B12 (GND), J9.B1_A12 (GND), J9.S1 (SHIELD), J9.S2 (SHIELD), J9.S3 (SHIELD), J9.S4 (SHIELD), J10.A1_B12 (GND), J10.B1_A12 (GND), J10.S1 (SHIELD), J10.S2 (SHIELD), J10.S3 (SHIELD), J10.S4 (SHIELD), R23.2, R24.2, R30.2, R33.2, R45.2, U7.12 (GND), U7.21 (GND), U8.2, U9.3 (GND), U9.4 (GND), U13.5 (GND), U13.7 (GND), U14.2 (GND); also elsewhere on the board
unnamed: Q2.2 (G2), Q2.4 (G1), U7.7 (GDC_g)
unnamed: Q2.1 (S2), Q2.3 (S1), U7.8 (GDC_s)
unnamed: Q3.2 (G2), Q3.4 (G1), U7.5 (GDP_g)
unnamed: Q3.1 (S2), Q3.3 (S1), U7.6 (GDP_s)
unnamed: C71.1, U7.14 (C_BIAS)
unnamed: R24.1, U7.16 (I2C_ADD)
unnamed: Q2.7 (D2), Q2.8 (D2), Q3.7 (D2), Q3.8 (D2), R21.1, U7.10 (I_SENSE)
unnamed: R22.2, R23.1, U7.11 (V_SENSE)
unnamed: R45.1, U13.2 (ILIM)
VBUS: C68.1, J9.A4_B9 (VBUS), J9.B4_A9 (VBUS), R21.2, R22.1, U7.9 (VBUS_c), U8.1

Notes on the sheet:
SOURCE
diff pair 90ohm
SINK

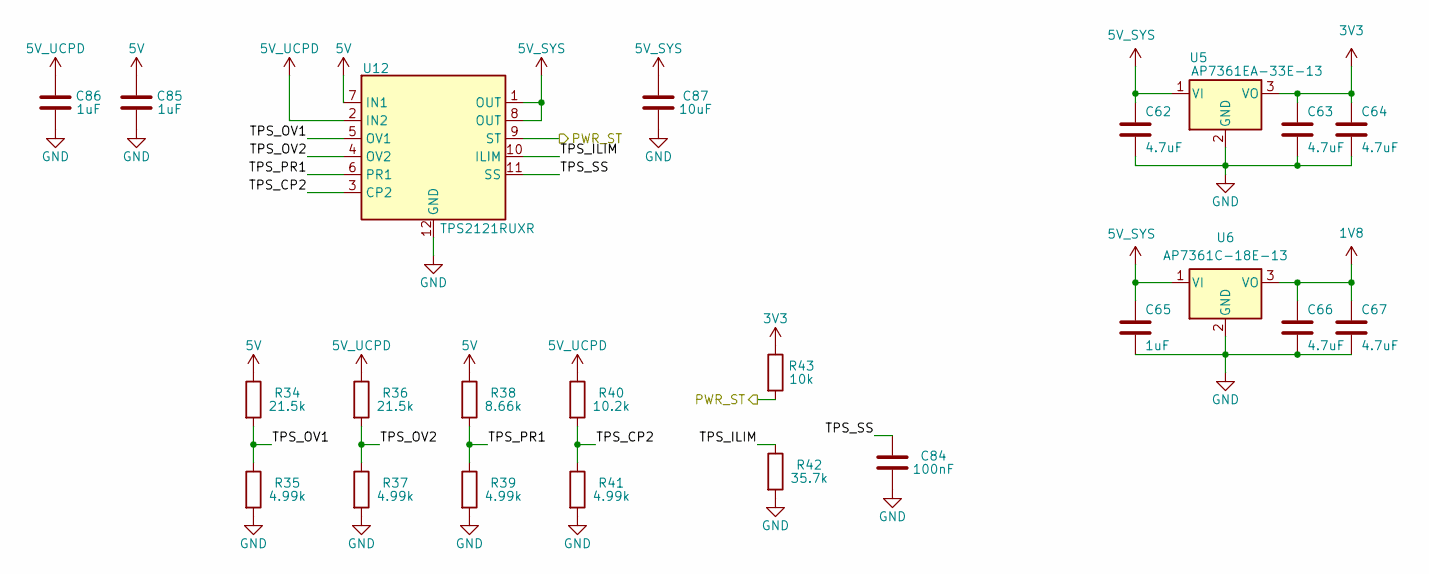
[picture p2: schematic power.kicad_sch]

Parts:
C62, C63, C64, C66, C67: 4.7uF; C_0603_1608Metric
C65: 1uF; C_0603_1608Metric
C84: 100nF; C_0201_0603Metric
C85, C86: 1uF; C_0402_1005Metric
C87: 10uF; C_0402_1005Metric
R34, R36: 21.5k; R_0201_0603Metric
R35, R37, R39, R41: 4.99k; R_0201_0603Metric
R38: 8.66k; R_0201_0603Metric
R40: 10.2k; R_0201_0603Metric
R42: 35.7k; R_0201_0603Metric
R43: 10k; R_0201_0603Metric
U5: AP7361EA-33E-13; SOT-223-3_TabPin2
U6: AP7361C-18E-13; SOT-223-3_TabPin2
U12: TPS2121RUXR; TI_RUX0012A_VQFN-HR-12_2x2.5mm_P0.5mm

Connections:
1V8: C66.1, C67.1, U6.3 (VO); also elsewhere on the board
3V3: C63.1, C64.1, R43.1, U5.3 (VO); also elsewhere on the board
5V: C85.1, R34.1, R38.1, U12.7 (IN1); also elsewhere on the board
5V_SYS: C62.1, C65.1, C87.1, U5.1 (VI), U6.1 (VI), U12.1 (OUT), U12.8 (OUT); also elsewhere on the board
5V_UCPD: C86.1, R36.1, R40.1, U12.2 (IN2); also elsewhere on the board
/MCU/PWR_ST: R43.2, U12.9 (ST); also elsewhere on the board
/Power/TPS_CP2: R40.2, R41.1, U12.3 (CP2)
/Power/TPS_ILIM: R42.1, U12.10 (ILIM)
/Power/TPS_OV1: R34.2, R35.1, U12.5 (OV1)
/Power/TPS_OV2: R36.2, R37.1, U12.4 (OV2)
/Power/TPS_PR1: R38.2, R39.1, U12.6 (PR1)
/Power/TPS_SS: C84.1, U12.11 (SS)
GND: C62.2, C63.2, C64.2, C65.2, C66.2, C67.2, C84.2, C85.2, C86.2, C87.2, R35.2, R37.2, R39.2, R41.2, R42.2, U5.2 (GND), U6.2 (GND), U12.12 (GND); also elsewhere on the board

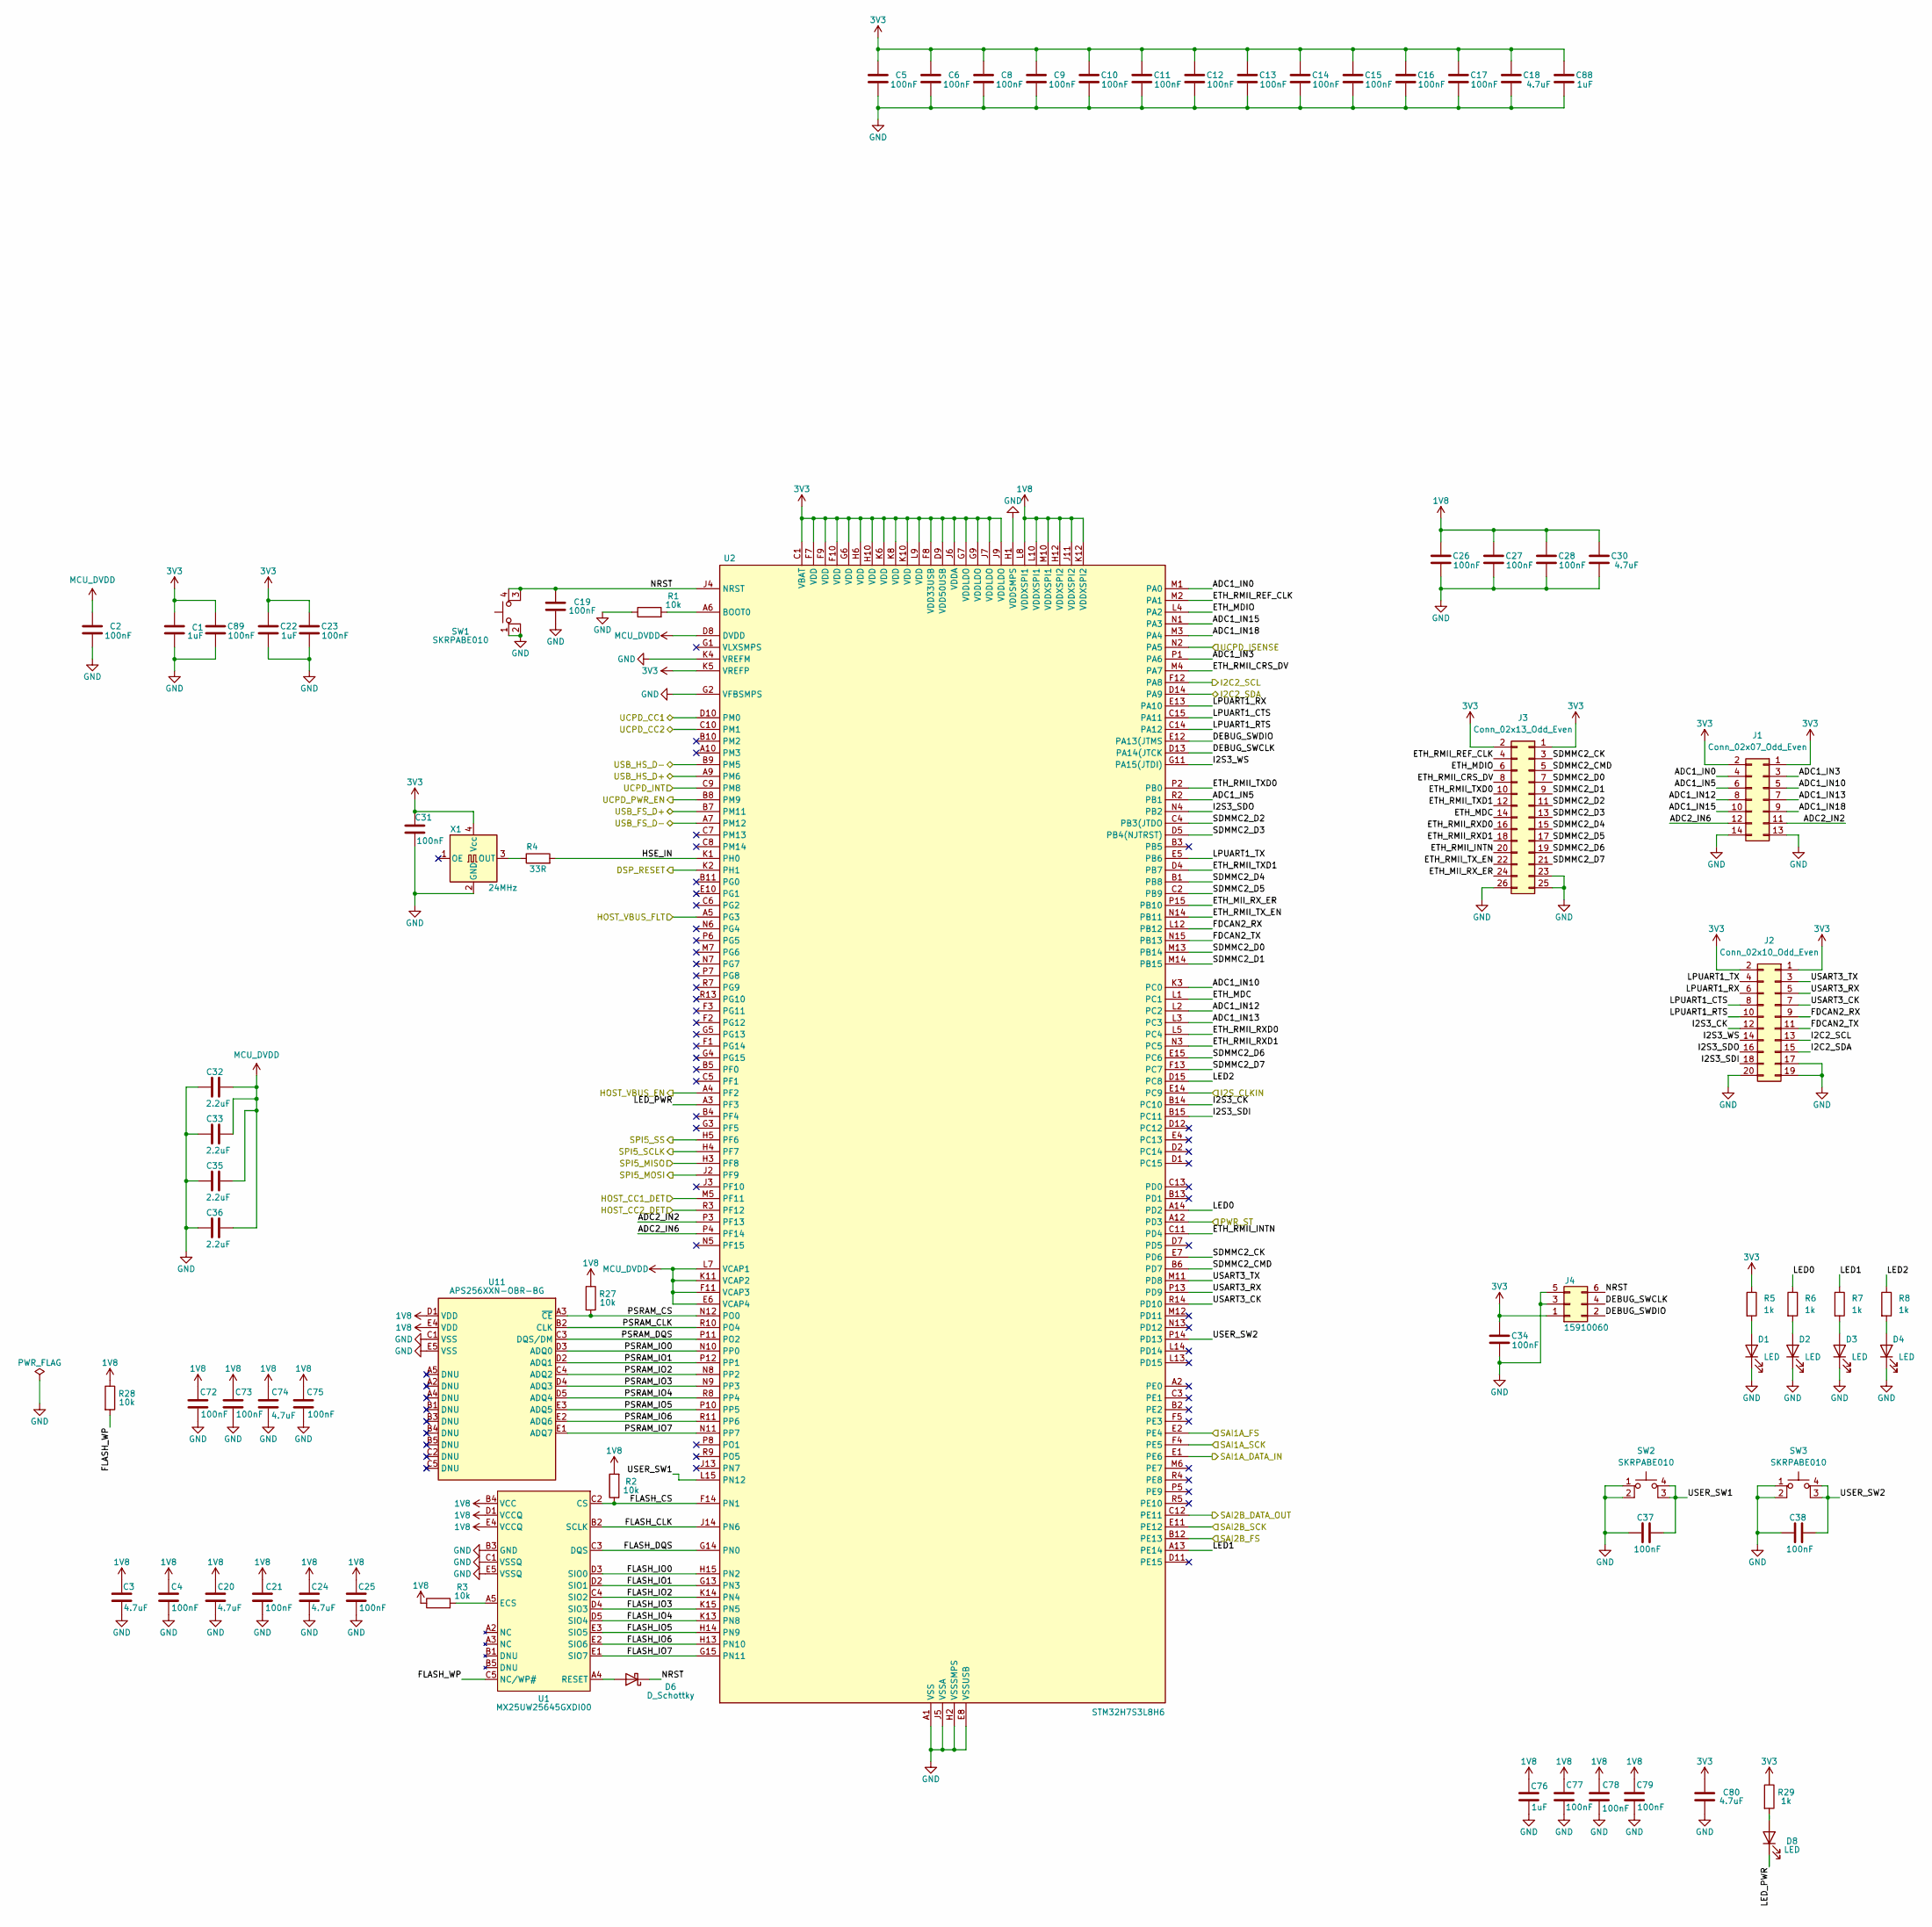
[picture p3: schematic mcu.kicad_sch]

Parts:
C1, C22, C76, C88: 1uF; C_0402_1005Metric
C2, C5, C6, C8, C9, C10, C11, C12, C13, C14, C15, C16, C17, C19, C23, C26, C27, C28, C31, C34, C37, C38, C72, C73, C75, C77, C78, C79, C89: 100nF; C_0201_0603Metric
C3, C18, C20, C24, C30, C74, C80: 4.7uF; C_0402_1005Metric
C4, C21, C25: 100nF; C_0402_1005Metric
C32, C33, C35, C36: 2.2uF; C_0402_1005Metric
D1, D2, D3, D4, D8: LED; LED_0603_1608Metric
D6: D_Schottky; D_SOD-523
J1: Conn_02x07_Odd_Even; PinSocket_2x07_P2.54mm_Vertical
J2: Conn_02x10_Odd_Even; PinSocket_2x10_P2.54mm_Vertical
J3: Conn_02x13_Odd_Even; PinSocket_2x13_P2.54mm_Vertical
J4: 15910060; PinHeader_2x03_P2.54mm_Vertical
R1, R2, R3, R27, R28: 10k; R_0201_0603Metric
R4: 33R; R_0201_0603Metric
R5, R6, R7, R8, R29: 1k; R_0201_0603Metric
SW1, SW2, SW3: SKRPABE010
U1: MX25UW25645GXDI00; BGA24C100P5X5_800X600X120
U2: STM32H7S3L8H6; ST_TFBGA-225_13x13mm_Layout15x15_P0.8mm
U11: APS256XXN-OBR-BG; BGA24C100P5X5_800X600X120
X1: 24MHz; Oscillator_SMD_SeikoEpson_SG210-4Pin_2.5x2.0mm

Connections:
1V8: C3.2, C4.2, C20.2, C21.2, C24.2, C25.2, C26.2, C27.2, C28.2, C30.2, C72.1, C73.1, C74.1, C75.1, C76.1, C77.1, C78.1, C79.1, R2.2, R3.1, R27.1, R28.1, U1.B4 (VCC), U1.D1 (VCCQ), U1.E4 (VCCQ), U2.H12 (VDDXSPI2), U2.J11 (VDDXSPI2), U2.K12 (VDDXSPI2), U2.L8 (VDDXSPI1), U2.L10 (VDDXSPI1), U2.M10 (VDDXSPI1), U11.D1 (VDD), U11.E4 (VDD); also elsewhere on the board
3V3: C1.2, C5.2, C6.2, C8.2, C9.2, C10.2, C11.2, C12.2, C13.2, C14.2, C15.2, C16.2, C17.2, C18.2, C22.2, C23.2, C31.2, C34.2, C80.1, C88.2, C89.2, J1.1, J1.2, J2.1, J2.2, J3.1, J3.2, J4.1, R5.1, R29.1, U2.C1 (VBAT), U2.D9 (VDD50USB), U2.F7 (VDD), U2.F8 (VDD33USB), U2.F9 (VDD), U2.F10 (VDD), U2.G6 (VDD), U2.G7 (VDDLDO), U2.G9 (VDDLDO), U2.H6 (VDD), U2.H10 (VDD), U2.J6 (VDDA), U2.J7 (VDDLDO), U2.J9 (VDDLDO), U2.K5 (VREFP), U2.K6 (VDD), U2.K8 (VDD), U2.K10 (VDD), U2.L9 (VDD), X1.4 (Vcc); also elsewhere on the board
/DSP/CLKOUT: U2.E14 (PC9); also elsewhere on the board
/DSP/DSP_BCLK_IN0: U2.E11 (PE12); also elsewhere on the board
/DSP/DSP_BCLK_OUT0: U2.F4 (PE5); also elsewhere on the board
/DSP/DSP_LRCLK_IN0: U2.B12 (PE13); also elsewhere on the board
/DSP/DSP_LRCLK_OUT0: U2.E2 (PE4); also elsewhere on the board
/DSP/DSP_RESET: U2.K2 (PH1); also elsewhere on the board
/DSP/DSP_SDATA_IN0: U2.C12 (PE11); also elsewhere on the board
/DSP/DSP_SDATA_OUT0: U2.E1 (PE6); also elsewhere on the board
/DSP/USBi_MISO: U2.H3 (PF8); also elsewhere on the board
/DSP/USBi_MOSI: U2.J2 (PF9); also elsewhere on the board
/DSP/USBi_SCLK: U2.H4 (PF7); also elsewhere on the board
/DSP/USBi_SS: U2.H5 (PF6); also elsewhere on the board
/MCU/ADC1_IN0: J1.4, U2.M1 (PA0)
/MCU/ADC1_IN3: J1.3, U2.P1 (PA6)
/MCU/ADC1_IN5: J1.6, U2.R2 (PB1)
/MCU/ADC1_IN10: J1.5, U2.K3 (PC0)
/MCU/ADC1_IN12: J1.8, U2.L2 (PC2)
/MCU/ADC1_IN13: J1.7, U2.L3 (PC3)
/MCU/ADC1_IN15: J1.10, U2.N1 (PA3)
/MCU/ADC1_IN18: J1.9, U2.M3 (PA4)
/MCU/ADC2_IN2: J1.11, U2.P3 (PF13)
/MCU/ADC2_IN6: J1.12, U2.P4 (PF14)
/MCU/DEBUG_SWCLK: J4.4, U2.D13 (PA14(JTCK)
/MCU/DEBUG_SWDIO: J4.2, U2.E12 (PA13(JTMS)
/MCU/ETH_MDC: J3.14, U2.L1 (PC1)
/MCU/ETH_MDIO: J3.6, U2.L4 (PA2)
/MCU/ETH_MII_RX_ER: J3.24, U2.P15 (PB10)
/MCU/ETH_RMII_CRS_DV: J3.8, U2.M4 (PA7)
/MCU/ETH_RMII_INTN: J3.20, U2.C11 (PD4)
/MCU/ETH_RMII_REF_CLK: J3.4, U2.M2 (PA1)
/MCU/ETH_RMII_RXD0: J3.16, U2.L5 (PC4)
/MCU/ETH_RMII_RXD1: J3.18, U2.N3 (PC5)
/MCU/ETH_RMII_TXD0: J3.10, U2.P2 (PB0)
/MCU/ETH_RMII_TXD1: J3.12, U2.D4 (PB7)
/MCU/ETH_RMII_TX_EN: J3.22, U2.N14 (PB11)
/MCU/FDCAN2_RX: J2.9, U2.L12 (PB12)
/MCU/FDCAN2_TX: J2.11, U2.N15 (PB13)
/MCU/FLASH_CLK: U1.B2 (SCLK), U2.J14 (PN6)
/MCU/FLASH_CS: R2.1, U1.C2 (CS), U2.F14 (PN1)
/MCU/FLASH_DQS: U1.C3 (DQS), U2.G14 (PN0)
/MCU/FLASH_IO0: U1.D3 (SIO0), U2.H15 (PN2)
/MCU/FLASH_IO1: U1.D2 (SIO1), U2.G13 (PN3)
/MCU/FLASH_IO2: U1.C4 (SIO2), U2.K14 (PN4)
/MCU/FLASH_IO3: U1.D4 (SIO3), U2.K15 (PN5)
/MCU/FLASH_IO4: U1.D5 (SIO4), U2.K13 (PN8)
/MCU/FLASH_IO5: U1.E3 (SIO5), U2.H14 (PN9)
/MCU/FLASH_IO6: U1.E2 (SIO6), U2.H13 (PN10)
/MCU/FLASH_IO7: U1.E1 (SIO7), U2.G15 (PN11)
/MCU/FLASH_WP: R28.2, U1.C5 (NC/WP#)
/MCU/HOST_CC1_DET: U2.M5 (PF11); also elsewhere on the board
/MCU/HOST_CC2_DET: U2.R3 (PF12); also elsewhere on the board
/MCU/HOST_VBUS_EN: U2.A4 (PF2); also elsewhere on the board
/MCU/HOST_VBUS_FLT: U2.A5 (PG3); also elsewhere on the board
/MCU/HSE_IN: R4.2, U2.K1 (PH0)
/MCU/I2C2_SCL: J2.13, U2.F12 (PA8); also elsewhere on the board
/MCU/I2C2_SDA: J2.15, U2.D14 (PA9); also elsewhere on the board
/MCU/I2S3_CK: J2.12, U2.B14 (PC10)
/MCU/I2S3_SDI: J2.18, U2.B15 (PC11)
/MCU/I2S3_SDO: J2.16, U2.N4 (PB2)
/MCU/I2S3_WS: J2.14, U2.G11 (PA15(JTDI))
/MCU/LED0: R6.1, U2.A14 (PD2)
/MCU/LED1: R7.1, U2.A13 (PE14)
/MCU/LED2: R8.1, U2.D15 (PC8)
/MCU/LED_PWR: D8.1 (K), U2.A3 (PF3)
/MCU/LPUART1_CTS: J2.8, U2.C15 (PA11)
/MCU/LPUART1_RTS: J2.10, U2.C14 (PA12)
/MCU/LPUART1_RX: J2.6, U2.E13 (PA10)
/MCU/LPUART1_TX: J2.4, U2.E5 (PB6)
/MCU/NRST: C19.2, D6.1 (K), J4.6, SW1.3 (K), SW1.4 (A), U2.J4 (NRST)
/MCU/PSRAM_CLK: U2.R10 (PO4), U11.B2 (CLK)
/MCU/PSRAM_CS: R27.2, U2.N12 (PO0), U11.A3 (~CE)
/MCU/PSRAM_DQS: U2.P11 (PO2), U11.C3 (DQS/DM)
/MCU/PSRAM_IO0: U2.N10 (PP0), U11.D3 (ADQ0)
/MCU/PSRAM_IO1: U2.P12 (PP1), U11.D2 (ADQ1)
/MCU/PSRAM_IO2: U2.N8 (PP2), U11.C4 (ADQ2)
/MCU/PSRAM_IO3: U2.N9 (PP3), U11.D4 (ADQ3)
/MCU/PSRAM_IO4: U2.R8 (PP4), U11.D5 (ADQ4)
/MCU/PSRAM_IO5: U2.P10 (PP5), U11.E3 (ADQ5)
/MCU/PSRAM_IO6: U2.R11 (PP6), U11.E2 (ADQ6)
/MCU/PSRAM_IO7: U2.N11 (PP7), U11.E1 (ADQ7)
/MCU/PWR_ST: U2.A12 (PD3); also elsewhere on the board
/MCU/SDMMC2_CK: J3.3, U2.E7 (PD6)
/MCU/SDMMC2_CMD: J3.5, U2.B6 (PD7)
/MCU/SDMMC2_D0: J3.7, U2.M13 (PB14)
/MCU/SDMMC2_D1: J3.9, U2.M14 (PB15)
/MCU/SDMMC2_D2: J3.11, U2.C4 (PB3(JTDO)
/MCU/SDMMC2_D3: J3.13, U2.D5 (PB4(NJTRST))
/MCU/SDMMC2_D4: J3.15, U2.B1 (PB8)
/MCU/SDMMC2_D5: J3.17, U2.C2 (PB9)
/MCU/SDMMC2_D6: J3.19, U2.E15 (PC6)
/MCU/SDMMC2_D7: J3.21, U2.F13 (PC7)
/MCU/UCPD_CC1: U2.D10 (PM0); also elsewhere on the board
/MCU/UCPD_CC2: U2.C10 (PM1); also elsewhere on the board
/MCU/UCPD_INT: U2.C9 (PM8); also elsewhere on the board
/MCU/UCPD_ISENSE: U2.N2 (PA5); also elsewhere on the board
/MCU/UCPD_PWR_EN: U2.B8 (PM9); also elsewhere on the board
/MCU/USART3_CK: J2.7, U2.R14 (PD10)
/MCU/USART3_RX: J2.5, U2.P13 (PD9)
/MCU/USART3_TX: J2.3, U2.M11 (PD8)
/MCU/USB_FS_D+: U2.B7 (PM11); also elsewhere on the board
/MCU/USB_FS_D-: U2.A7 (PM12); also elsewhere on the board
/MCU/USB_HS_D+: U2.A9 (PM6); also elsewhere on the board
/MCU/USB_HS_D-: U2.B9 (PM5); also elsewhere on the board
/MCU/USER_SW1: C37.2, SW2.3 (K), SW2.4 (A), U2.L15 (PN12)
/MCU/USER_SW2: C38.2, SW3.3 (K), SW3.4 (A), U2.P14 (PD13)
GND: C1.1, C2.1, C3.1, C4.1, C5.1, C6.1, C8.1, C9.1, C10.1, C11.1, C12.1, C13.1, C14.1, C15.1, C16.1, C17.1, C18.1, C19.1, C20.1, C21.1, C22.1, C23.1, C24.1, C25.1, C26.1, C27.1, C28.1, C30.1, C31.1, C32.1, C33.1, C34.1, C35.1, C36.1, C37.1, C38.1, C72.2, C73.2, C74.2, C75.2, C76.2, C77.2, C78.2, C79.2, C80.2, C88.1, C89.1, D1.1 (K), D2.1 (K), D3.1 (K), D4.1 (K), J1.13, J1.14, J2.17, J2.19, J2.20, J3.23, J3.25, J3.26, J4.3, J4.5, R1.1, SW1.1, SW1.2, SW2.1, SW2.2, SW3.1, SW3.2, U1.B3 (GND), U1.C1 (VSSQ), U1.E5 (VSSQ), U2.A1 (VSS), U2.A8 (VSS), U2.A11 (VSS), U2.A15 (VSS), U2.D3 (VSS), U2.D6 (VSS), U2.E3 (VSS), U2.E8 (VSSUSB), U2.E9 (VSS), U2.F6 (VSS), U2.F15 (VSS), U2.G2 (VFBSMPS), U2.G8 (VSS), U2.G10 (VSS), U2.G12 (VSS), U2.H1 (VDDSMPS), U2.H2 (VSSSMPS), U2.H7 (VSS), U2.H8 (VSS), U2.H9 (VSS), U2.H11 (VSS), U2.J1 (VSS), U2.J5 (VSSA), U2.J8 (VSS), U2.J10 (VSS), U2.J12 (VSS), U2.J15 (VSS), U2.K4 (VREFM), U2.K7 (VSS), U2.K9 (VSS), U2.L6 (VSS), U2.L11 (VSS), U2.M8 (VSS), U2.M9 (VSS), U2.M15 (VSS), U2.P9 (VSS), U2.R1 (VSS), U2.R6 (VSS), U2.R12 (VSS), U2.R15 (VSS), U11.C1 (VSS), U11.E5 (VSS), X1.2 (GND); also elsewhere on the board
MCU_DVDD: C2.2, C32.2, C33.2, C35.2, C36.2, U2.D8 (DVDD), U2.E6 (VCAP4), U2.F11 (VCAP3), U2.K11 (VCAP2), U2.L7 (VCAP1)
unnamed: D1.2 (A), R5.2
unnamed: D2.2 (A), R6.2
unnamed: D3.2 (A), R7.2
unnamed: D4.2 (A), R8.2
unnamed: D6.2 (A), U1.A4 (RESET)
unnamed: D8.2 (A), R29.2
unnamed: R3.2, U1.A5 (ECS)
unnamed: R1.2, U2.A6 (BOOT0)
unnamed: R4.1, X1.3 (OUT)

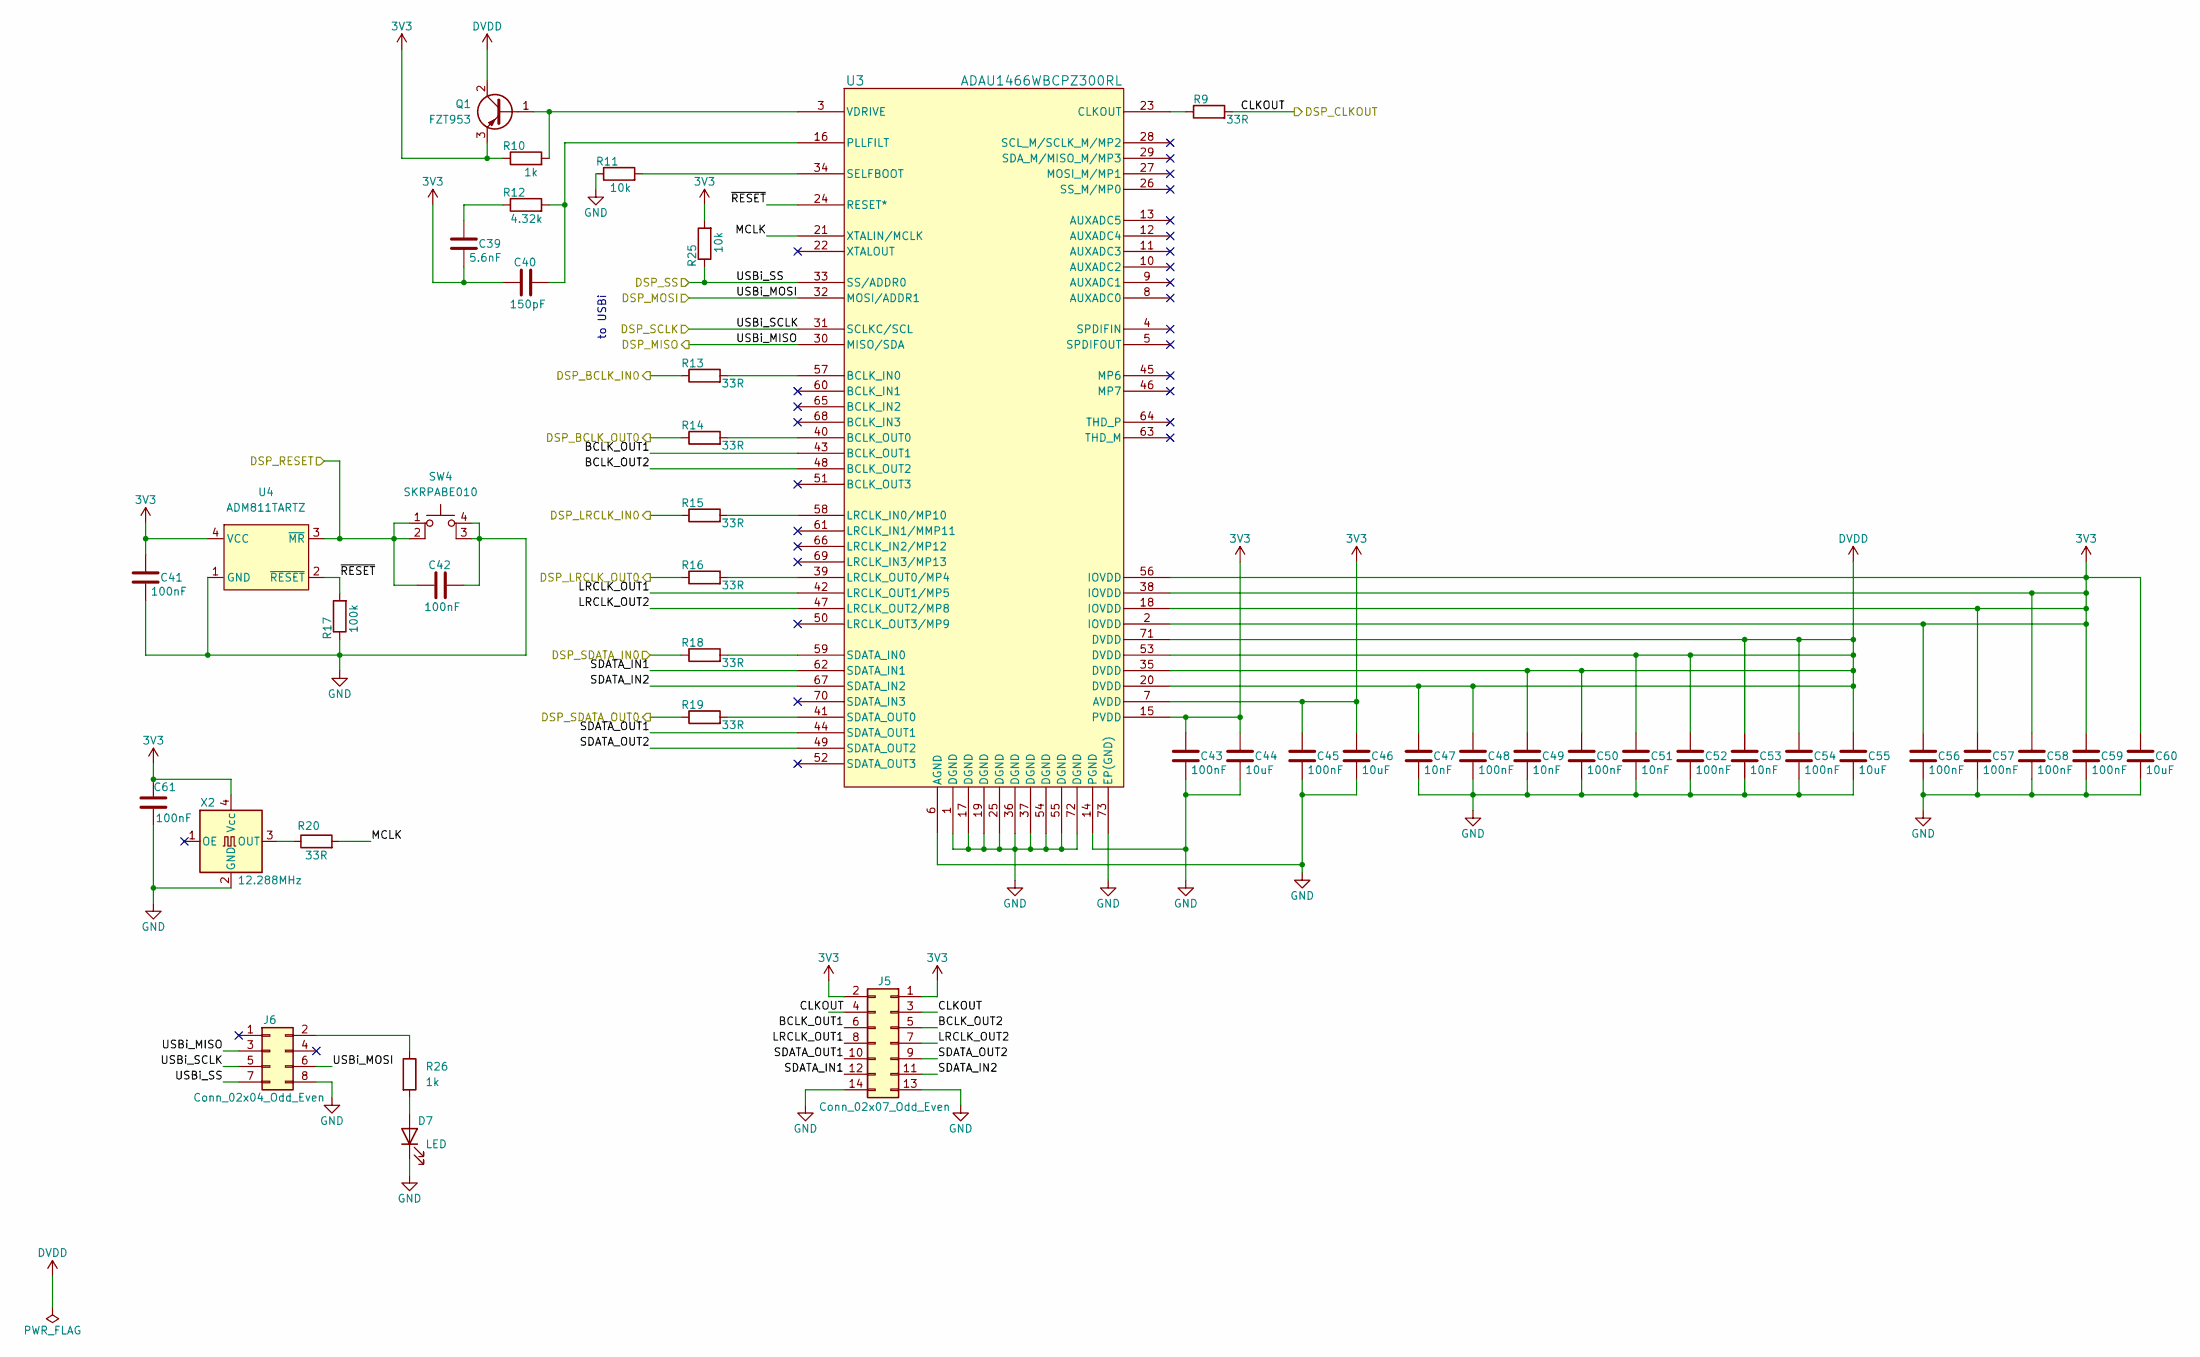
[picture p4: schematic dsp.kicad_sch]

Parts:
C39: 5.6nF; C_0201_0603Metric
C40: 150pF; C_0201_0603Metric
C41, C42, C43, C45, C48, C50, C52, C54, C56, C57, C58, C59: 100nF; C_0201_0603Metric
C44, C46, C55, C60: 10uF; C_0402_1005Metric
C47, C49, C51, C53: 10nF; C_0201_0603Metric
C61: 100nF; C_0402_1005Metric
D7: LED; LED_0603_1608Metric
J5: Conn_02x07_Odd_Even; PinSocket_2x07_P2.54mm_Vertical
J6: Conn_02x04_Odd_Even; PinHeader_2x04_P2.54mm_Vertical
Q1: FZT953; SOT-223-3_TabPin2
R9, R13, R14, R15, R16, R18, R19, R20: 33R; R_0201_0603Metric
R10, R26: 1k; R_0201_0603Metric
R11, R25: 10k; R_0201_0603Metric
R12: 4.32k; R_0201_0603Metric
R17: 100k; R_0201_0603Metric
SW4: SKRPABE010
U3: ADAU1466WBCPZ300RL; CP_72_6_ADI
U4: ADM811TARTZ; SOT-143
X2: 12.288MHz; Oscillator_SMD_SeikoEpson_SG210-4Pin_2.5x2.0mm

Connections:
3V3: C39.2, C40.1, C41.1, C43.1, C44.1, C45.1, C46.1, C56.1, C57.1, C58.1, C59.1, C60.1, C61.2, J5.1, J5.2, Q1.3 (E), R10.1, R25.2, U3.2 (IOVDD), U3.7 (AVDD), U3.15 (PVDD), U3.18 (IOVDD), U3.38 (IOVDD), U3.56 (IOVDD), U4.4 (VCC), X2.4 (Vcc); also elsewhere on the board
/DSP/BCLK_OUT1: J5.6, U3.43 (BCLK_OUT1)
/DSP/BCLK_OUT2: J5.5, U3.48 (BCLK_OUT2)
/DSP/CLKOUT: J5.3, J5.4, R9.2; also elsewhere on the board
/DSP/DSP_BCLK_IN0: R13.1; also elsewhere on the board
/DSP/DSP_BCLK_OUT0: R14.1; also elsewhere on the board
/DSP/DSP_LRCLK_IN0: R15.1; also elsewhere on the board
/DSP/DSP_LRCLK_OUT0: R16.1; also elsewhere on the board
/DSP/DSP_RESET: C42.1, SW4.1, SW4.2, U4.3 (~MR); also elsewhere on the board
/DSP/DSP_SDATA_IN0: R18.1; also elsewhere on the board
/DSP/DSP_SDATA_OUT0: R19.1; also elsewhere on the board
/DSP/LRCLK_OUT1: J5.8, U3.42 (LRCLK_OUT1/MP5)
/DSP/LRCLK_OUT2: J5.7, U3.47 (LRCLK_OUT2/MP8)
/DSP/MCLK: R20.2, U3.21 (XTALIN/MCLK)
/DSP/SDATA_IN1: J5.12, U3.62 (SDATA_IN1)
/DSP/SDATA_IN2: J5.11, U3.67 (SDATA_IN2)
/DSP/SDATA_OUT1: J5.10, U3.44 (SDATA_OUT1)
/DSP/SDATA_OUT2: J5.9, U3.49 (SDATA_OUT2)
/DSP/USBi_MISO: J6.3, U3.30 (MISO/SDA); also elsewhere on the board
/DSP/USBi_MOSI: J6.6, U3.32 (MOSI/ADDR1); also elsewhere on the board
/DSP/USBi_SCLK: J6.5, U3.31 (SCLKC/SCL); also elsewhere on the board
/DSP/USBi_SS: J6.7, R25.1, U3.33 (SS/ADDR0); also elsewhere on the board
/DSP/~RESET: R17.2, U3.24 (RESET*), U4.2 (~RESET)
DVDD: C47.1, C48.1, C49.1, C50.1, C51.1, C52.1, C53.1, C54.1, C55.1, Q1.2 (C), U3.20 (DVDD), U3.35 (DVDD), U3.53 (DVDD), U3.71 (DVDD)
GND: C41.2, C42.2, C43.2, C44.2, C45.2, C46.2, C47.2, C48.2, C49.2, C50.2, C51.2, C52.2, C53.2, C54.2, C55.2, C56.2, C57.2, C58.2, C59.2, C60.2, C61.1, D7.1 (K), J5.13, J5.14, J6.8, R11.1, R17.1, SW4.3 (K), SW4.4 (A), U3.1 (DGND), U3.6 (AGND), U3.14 (PGND), U3.17 (DGND), U3.19 (DGND), U3.25 (DGND), U3.36 (DGND), U3.37 (DGND), U3.54 (DGND), U3.55 (DGND), U3.72 (DGND), U3.73 (EP(GND)), U4.1 (GND), X2.2 (GND); also elsewhere on the board
unnamed: C39.1, R12.1
unnamed: D7.2 (A), R26.2
unnamed: J6.2, R26.1
unnamed: Q1.1 (B), R10.2, U3.3 (VDRIVE)
unnamed: R13.2, U3.57 (BCLK_IN0)
unnamed: R14.2, U3.40 (BCLK_OUT0)
unnamed: R9.1, U3.23 (CLKOUT)
unnamed: R15.2, U3.58 (LRCLK_IN0/MP10)
unnamed: R16.2, U3.39 (LRCLK_OUT0/MP4)
unnamed: C40.2, R12.2, U3.16 (PLLFILT)
unnamed: R18.2, U3.59 (SDATA_IN0)
unnamed: R19.2, U3.41 (SDATA_OUT0)
unnamed: R11.2, U3.34 (SELFBOOT)
unnamed: R20.1, X2.3 (OUT)

Notes on the sheet:
to USBi
