YamamotoWorksDev/STM32H7S3_Dev_Board_v2/STM32H7S3_Dev_Board.kicad_pcb

## KiCad design STM32H7S3_Dev_Board.kicad_pcb (continued)

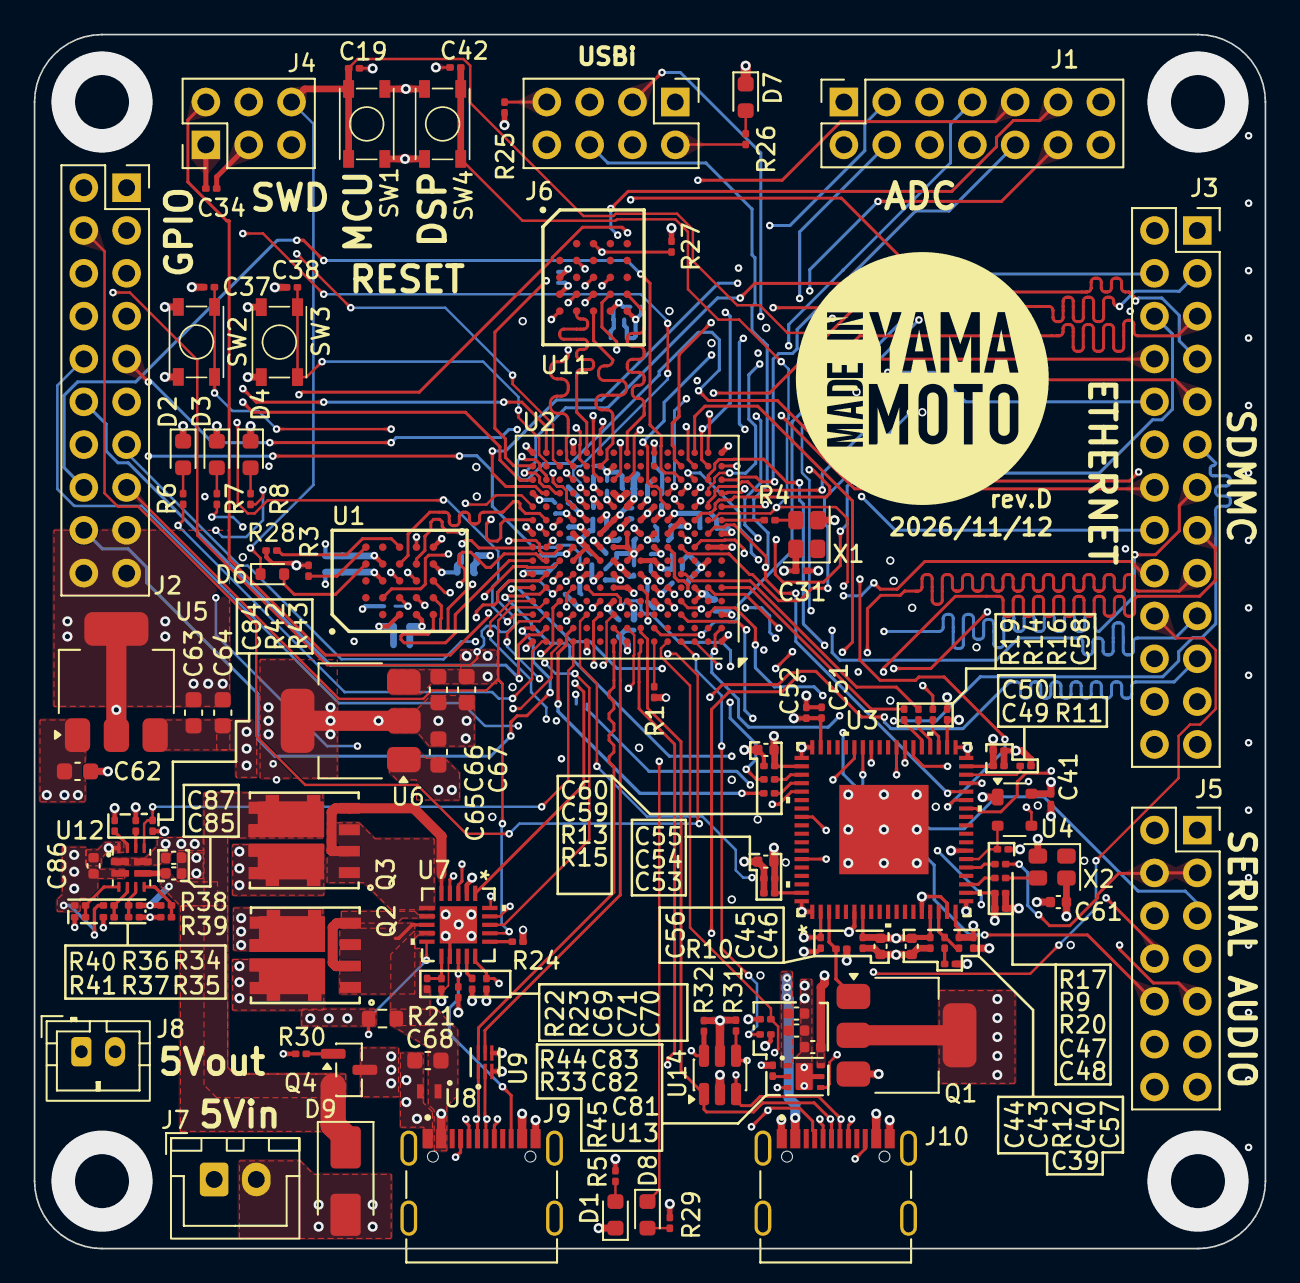
[picture p5: board STM32H7S3_Dev_Board.kicad_pcb from above]

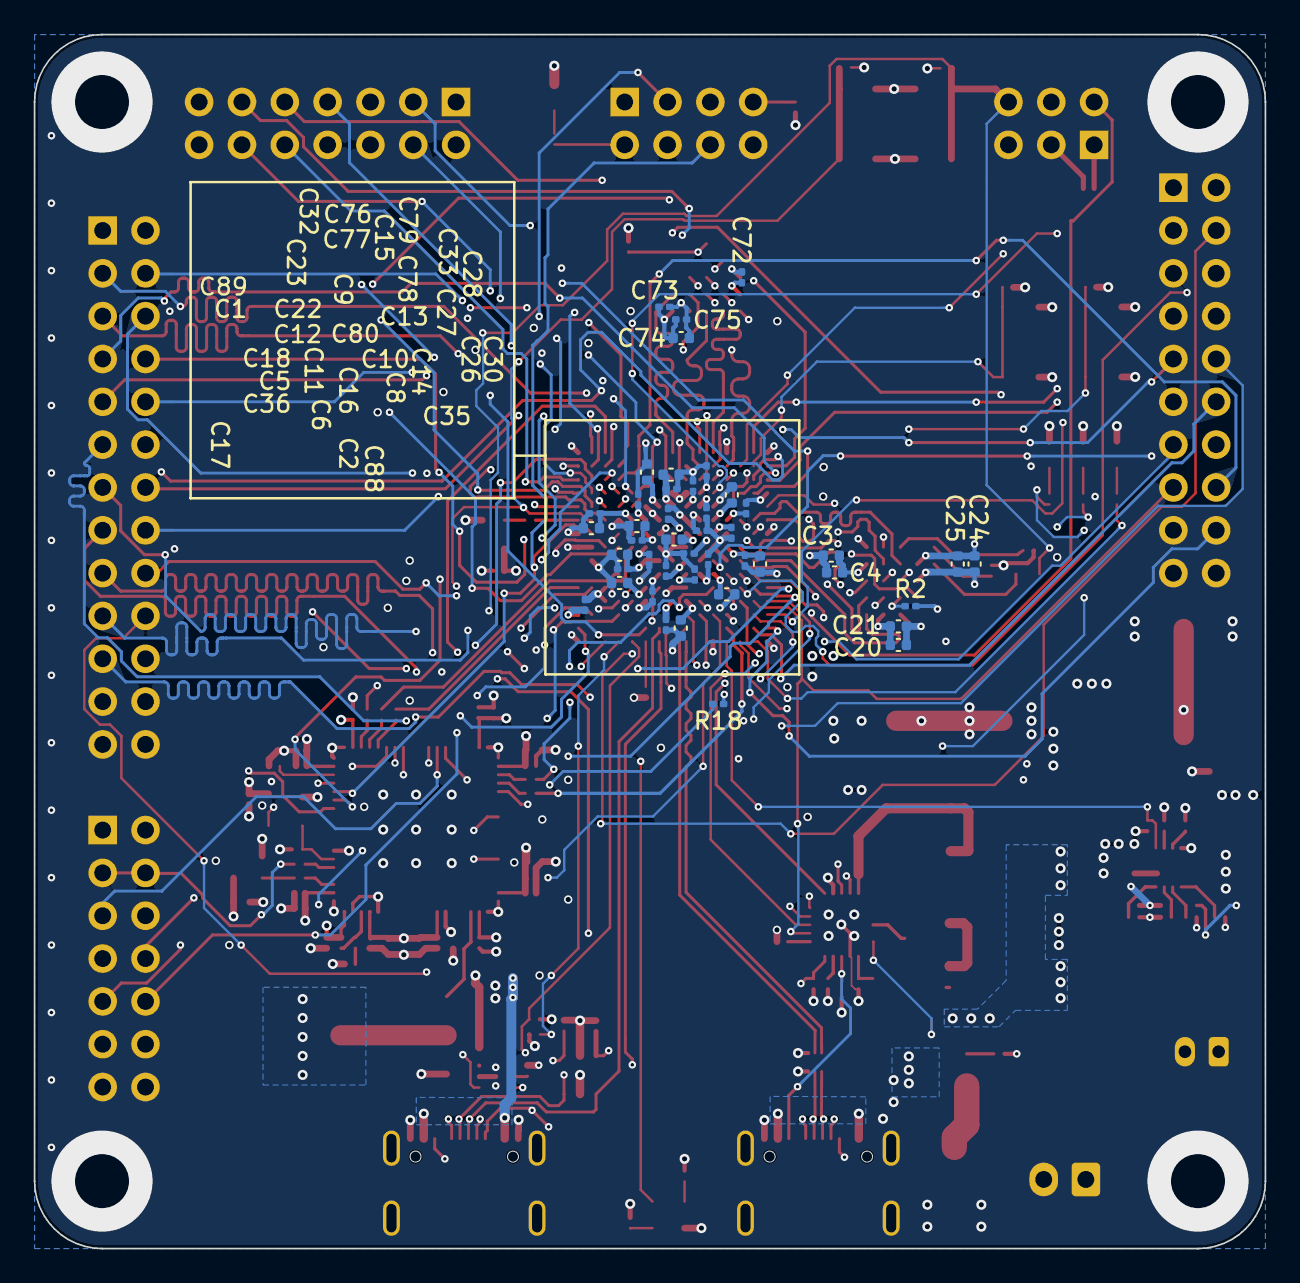
[picture p6: board STM32H7S3_Dev_Board.kicad_pcb from below]

Board: 6 copper layers, 73.0 x 72.0 mm, 173 parts (44 on the bottom side), 169 nets.
