YamamotoWorksDev/STM32H7S3_Dev_Board_v2/(commit log)

2026-11-06 rev.Dの履歴復元方針と管理対象を定義
    保存記録とハッシュから再構成する履歴の対象・順序・制約を記録する。
    作業用データとKiCadの一時ファイル・生成物をGit管理から除外する。
    KiCad原本と既存設計文書の改行を保存し、Gitの自動変換による原本差異を防ぐ。
2026-11-06 rev.Dの最初に確認できる保存状態を取り込み
    過去の保存記録から再構成した履歴。元の作業日時・作者を再現するものではない。
    参照記録: .work/decoupling-rework
    最初に原本を確認できるPCB・設計書・設定を取り込む。回路図は原本を確認できる時点から追加する。
    [STM32H7S3_Dev_Board.kicad_pcb]
2026-11-06 MCUデカップリング部品の配置と配線を整理
    保存記録または検証済み採用ファイルに対応する結果を反映する。
    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
    [STM32H7S3_Dev_Board.kicad_pcb]
2026-11-06 保存済み調整を反映（u11-decoupling-20261029開始前）
    参照記録: .work/u11-decoupling-20261029
    前回の採用結果と次の確認済み保存状態の差分を反映する。変更者・詳細時刻は断定しない。
    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
    [STM32H7S3_Dev_Board.kicad_pcb]
2026-11-06 PSRAMのデカップリング配置を改善
    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
    [STM32H7S3_Dev_Board.kicad_pcb]
2026-11-06 保存済み調整を反映（u1-c24-c25-20261029開始前）
    参照記録: .work/u1-c24-c25-20261029
    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
    [STM32H7S3_Dev_Board.kicad_pcb]
2026-11-06 FLASHのC24・C25周辺配線を整理
    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
    [STM32H7S3_Dev_Board.kicad_pcb]
2026-11-06 保存済み調整を反映（u1-c3-20261029開始前）
    参照記録: .work/u1-c3-20261029
    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
    [STM32H7S3_Dev_Board.kicad_pcb]
2026-11-06 FLASHのC3を再配置
    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
    [STM32H7S3_Dev_Board.kicad_pcb]
2026-11-06 保存済み調整を反映（u2-c18-c30-20261029開始前）
    参照記録: .work/u2-c18-c30-20261029
    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
    [STM32H7S3_Dev_Board.kicad_pcb]
2026-11-06 MCUのC18・C30を再配置
    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
    [STM32H7S3_Dev_Board.kicad_pcb]
2026-11-06 保存済み調整を反映（u2-five-power-20261029開始前）
    参照記録: .work/u2-five-power-20261029
    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
    [STM32H7S3_Dev_Board.kicad_pcb]
2026-11-06 MCU電源ピン周辺を整理しC88を追加
    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
    [STM32H7S3_Dev_Board.kicad_pcb, mcu.kicad_sch]
2026-11-06 保存済み調整を反映（power-routing-20261029開始前）
    参照記録: .work/power-routing-20261029
    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
    [STM32H7S3_Dev_Board.kicad_pcb]
2026-11-06 電源経路とデカップリング配線を整理
    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
    [STM32H7S3_Dev_Board.kicad_pcb]
2026-11-06 保存済み調整を反映（input-vbus-20261029開始前）
    参照記録: .work/input-vbus-20261029
    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
    [STM32H7S3_Dev_Board.kicad_pcb, STM32H7S3_Dev_Board.kicad_sch, dsp.kicad_sch, power.kicad_sch, usb.kicad_sch]
2026-11-06 入力電源とVBUS経路を整理
    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
    [STM32H7S3_Dev_Board.kicad_pcb]
2026-11-06 保存済み調整を反映（c68-solid-20261029開始前）
    参照記録: .work/c68-solid-20261029
    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
    [STM32H7S3_Dev_Board.kicad_pcb]
2026-11-06 C68周辺の電源接続を改善
    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
    [STM32H7S3_Dev_Board.kicad_pcb]
2026-11-06 保存済み調整を反映（power-zone-cleanup-20261029開始前）
    参照記録: .work/power-zone-cleanup-20261029
    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
    [STM32H7S3_Dev_Board.kicad_pcb]
2026-11-06 電源ゾーンと未使用銅箔を整理
    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
    [STM32H7S3_Dev_Board.kicad_pcb]
2026-11-06 保存済み調整を反映（ground-axis-20261029開始前）
    参照記録: .work/ground-axis-20261029
    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
    [STM32H7S3_Dev_Board.kicad_pcb]
2026-11-06 GND接続と引き出し形状を整理
    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
    [STM32H7S3_Dev_Board.kicad_pcb]
2026-11-06 保存済み調整を反映（u5-output-20261030開始前）
    参照記録: .work/u5-output-20261030
    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
    [STM32H7S3_Dev_Board.kicad_pcb]
2026-11-06 U5の出力コンデンサ周辺を整理
    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
    [STM32H7S3_Dev_Board.kicad_pcb]
2026-11-06 5V_SYSを内層の電源ゾーンへ移設
    参照記録: .work/sys-inner-20261030
    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
    [STM32H7S3_Dev_Board.kicad_pcb]
2026-11-06 保存済み調整を反映（c67-axis-20261030開始前）
    参照記録: .work/c67-axis-20261030
    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
    [STM32H7S3_Dev_Board.kicad_pcb]
2026-11-06 C67の接続形状を整理
    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
    [STM32H7S3_Dev_Board.kicad_pcb]
2026-11-06 保存済み調整を反映（ucpd-width-review-20261030開始前）
    参照記録: .work/ucpd-width-review-20261030
    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
    [STM32H7S3_Dev_Board.kicad_pcb]
2026-11-06 保存済み調整を反映（usb-fs-20261030開始前）
    参照記録: .work/usb-fs-20261030
    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
    [STM32H7S3_Dev_Board.kicad_pcb]
2026-11-06 U14周辺のUSB FS配線を引き直し
    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
    [STM32H7S3_Dev_Board.kicad_pcb]
2026-11-06 保存済み調整を反映（usb-fs-u14-tight-20261030開始前）
    参照記録: .work/usb-fs-u14-tight-20261030
    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
    [STM32H7S3_Dev_Board.kicad_pcb]
2026-11-06 U14のUSB FS差動配線を改善
    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
    [STM32H7S3_Dev_Board.kicad_pcb]
2026-11-06 保存済み調整を反映（5vin-review-20261030開始前）
    参照記録: .work/5vin-review-20261030
    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
    [STM32H7S3_Dev_Board.kicad_pcb]
2026-11-06 保存済み調整を反映（vbus-zones-review-20261030開始前）
    参照記録: .work/vbus-zones-review-20261030
    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
    [STM32H7S3_Dev_Board.kicad_pcb]
2026-11-06 保存済み調整を反映（power-cleanup-review-20261030開始前）
    参照記録: .work/power-cleanup-review-20261030
    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
    [STM32H7S3_Dev_Board.kicad_pcb]
2026-11-06 保存済み調整を反映（oscillators-20261030開始前）
    参照記録: .work/oscillators-20261030
    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
    [mcu.kicad_sch, power.kicad_sch]
2026-11-06 X1・X2の配置とクロック配線を整理
    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
    [STM32H7S3_Dev_Board.kicad_pcb]
2026-11-06 保存済み調整を反映（usb-bga-review-20261030開始前）
    参照記録: .work/usb-bga-review-20261030
    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
    [STM32H7S3_Dev_Board.kicad_pcb]
2026-11-06 USBのBGA引き出し線幅を見直し
    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
    [STM32H7S3_Dev_Board.kicad_pcb]
2026-11-06 PSRAM配線の線幅と経路を見直し
    参照記録: .work/psram-width-20261030
    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
    [STM32H7S3_Dev_Board.kicad_pcb]
2026-11-06 FLASH配線の線幅と経路を見直し
    参照記録: .work/flash-width-20261030
    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
    [STM32H7S3_Dev_Board.kicad_pcb]
2026-11-06 保存済み調整を反映（u2-manual-review-20261030開始前）
    参照記録: .work/u2-manual-review-20261030
    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
    [STM32H7S3_Dev_Board.kicad_pcb]
2026-11-06 保存済み調整を反映（dvdd-r27-recheck-20261030開始前）
    参照記録: .work/dvdd-r27-recheck-20261030
    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
    [STM32H7S3_Dev_Board.kicad_pcb]
2026-11-06 DVDD周辺とR27付近の不要配線を整理
    参照記録: .work/dvdd-r27-cleanup-20261030
    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
    [STM32H7S3_Dev_Board.kicad_pcb]
2026-11-06 SWD・SAI・SPIとDSP周辺を配線
    参照記録: .work/digital-routing-20261030
    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
    [STM32H7S3_Dev_Board.kicad_pcb]
2026-11-06 配線の幅変更と不要な曲げを整理
    参照記録: .work/routing-style-20261030
    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
    [STM32H7S3_Dev_Board.kicad_pcb]
2026-11-06 保存済み調整を反映（usb-control-routing-20261030開始前）
    参照記録: .work/usb-control-routing-20261030
    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
2026-11-06 J9・J10・U7の残配線を接続
    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
    [STM32H7S3_Dev_Board.kicad_pcb]
2026-11-06 ビア近傍の配線形状を整理
    参照記録: .work/usb-via-cleanup-20261031
    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
    [STM32H7S3_Dev_Board.kicad_pcb]
2026-11-06 保存済み調整を反映（hostcc2-width-20261031開始前）
    参照記録: .work/hostcc2-width-20261031
    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
    [STM32H7S3_Dev_Board.kicad_pcb]
2026-11-06 HOST_CC2_DETの線幅と経路を改善
    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
    [STM32H7S3_Dev_Board.kicad_pcb]
2026-11-06 保存済み調整を反映（hostcc2-restore-20261031開始前）
    参照記録: .work/hostcc2-restore-20261031
    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
    [STM32H7S3_Dev_Board.kicad_pcb]
2026-11-06 手動保存後のHOST_CC2_DET修正を再反映
    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
    [STM32H7S3_Dev_Board.kicad_pcb]
2026-11-06 保存済み調整を反映（ucpd-isense-route-20261102開始前）
    参照記録: .work/ucpd-isense-route-20261102
    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
    [STM32H7S3_Dev_Board.kicad_pcb]
2026-11-06 UCPD_ISENSEの経路を整理
    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
    [STM32H7S3_Dev_Board.kicad_pcb]
2026-11-06 保存済み調整を反映（dvdd-inner-20261102開始前）
    参照記録: .work/dvdd-inner-20261102
    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
    [STM32H7S3_Dev_Board.kicad_pcb]
2026-11-06 DVDDを内層へ移設しDSP周辺信号を整理
    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
    [STM32H7S3_Dev_Board.kicad_pcb]
2026-11-06 保存済み調整を反映（usbi-ss-review-20261102開始前）
    参照記録: .work/usbi-ss-review-20261102
    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
    [STM32H7S3_Dev_Board.kicad_pcb]
2026-11-06 保存済み調整を反映（usbi-sclk-review-20261102開始前）
    参照記録: .work/usbi-sclk-review-20261102
    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
    [STM32H7S3_Dev_Board.kicad_pcb]
2026-11-06 保存済み調整を反映（status-control-20261102開始前）
    参照記録: .work/status-control-20261102
    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
    [STM32H7S3_Dev_Board.kicad_pcb]
2026-11-06 電源状態とホスト電源制御とLEDを配線
    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
    [STM32H7S3_Dev_Board.kicad_pcb]
2026-11-06 保存済み調整を反映（reset-switch-swap-20261102開始前）
    参照記録: .work/reset-switch-swap-20261102
    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
    [STM32H7S3_Dev_Board.kicad_pcb]
2026-11-06 SW4とSW1の配置と配線を変更
    参照記録: .work/reset-switch-relocation-20261102
    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
    [STM32H7S3_Dev_Board.kicad_pcb]
2026-11-06 MCUとJ3のRMII・SDMMC配線を接続
    参照記録: .work/u2-j3-routing-20261102
    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
    [STM32H7S3_Dev_Board.kicad_pcb]
2026-11-06 保存済み調整を反映（d2-width-review-20261103開始前）
    参照記録: .work/d2-width-review-20261103
    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
    [STM32H7S3_Dev_Board.kicad_pcb]
2026-11-06 SDMMC周辺の細線区間と迂回を見直し
    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
    [STM32H7S3_Dev_Board.kicad_pcb]
2026-11-06 SDMMCのD0からD3の信号ビア数を統一
    参照記録: .work/sdmmc-four-vias-20261103
    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
    [STM32H7S3_Dev_Board.kicad_pcb]
2026-11-06 保存済み調整を反映（adc-j1-routing-20261103開始前）
    参照記録: .work/adc-j1-routing-20261103
    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
    [STM32H7S3_Dev_Board.kicad_pcb]
2026-11-06 J1を14ピンへ拡張しADC入力を配線
    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
    [STM32H7S3_Dev_Board.kicad_pcb, mcu.kicad_sch]
2026-11-06 J1・J6を移動しJ1のGNDピンを変更
    参照記録: .work/j1-j6-shift-20261104
    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
    [STM32H7S3_Dev_Board.kicad_pcb, mcu.kicad_sch]
2026-11-06 ADC1_IN10の線幅を統一
    参照記録: .work/adc-in10-width-20261104
    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
    [STM32H7S3_Dev_Board.kicad_pcb]
2026-11-06 ADC1_IN5の曲がりと線幅を整理
    参照記録: .work/adc-in5-style-20261104
    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
    [STM32H7S3_Dev_Board.kicad_pcb]
2026-11-06 USBi_SSの線幅と経路を整理
    参照記録: .work/usbi-ss-style-20261104
    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
    [STM32H7S3_Dev_Board.kicad_pcb]
2026-11-06 ADC1_IN3の線幅変更を整理
    参照記録: .work/adc-in3-style-20261104
    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
    [STM32H7S3_Dev_Board.kicad_pcb]
2026-11-06 ETH_MDIOの線幅と経路を整理
    参照記録: .work/eth-mdio-style-20261104
    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
    [STM32H7S3_Dev_Board.kicad_pcb]
2026-11-06 基板全体の線幅と経路を整理
    参照記録: .work/board-style-review-20261104
    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
    [STM32H7S3_Dev_Board.kicad_pcb]
2026-11-06 FLASHのECSとRESET周辺配線を完了
    参照記録: .work/flash-control-completion-20261104
    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
    [STM32H7S3_Dev_Board.kicad_pcb]
2026-11-06 I2C2_SDAの重複配線を除去
    参照記録: .work/i2c-sda-overlap-20261104
    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
    [STM32H7S3_Dev_Board.kicad_pcb]
2026-11-06 保存済み調整を反映（remaining-routing-20261104開始前）
    参照記録: .work/remaining-routing-20261104
    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
    [STM32H7S3_Dev_Board.kicad_pcb]
2026-11-06 J2・スイッチ・LEDの残配線を完了
    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
    [STM32H7S3_Dev_Board.kicad_pcb]
2026-11-06 保存済み調整を反映（sai-pad-clearance-20261105開始前）
    参照記録: .work/sai-pad-clearance-20261105
    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
2026-11-06 SAI経路とC28・R3周辺を改善
    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
    [STM32H7S3_Dev_Board.kicad_pcb]
2026-11-06 LED1・LED2のMCUピン割当てを変更
    参照記録: .work/led-pin-relocation-20261105
    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
    [STM32H7S3_Dev_Board.kicad_pcb, mcu.kicad_sch]
2026-11-06 保存済み調整を反映（sai2b-schematic-20261105開始前）
    参照記録: .work/sai2b-schematic-20261105
    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
    [STM32H7S3_Dev_Board.kicad_pcb]
2026-11-06 SAI2BのE11・C12・B12へ回路図を変更
    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
    [STM32H7S3_Dev_Board.kicad_sch, mcu.kicad_sch]
2026-11-06 保存済み調整を反映（sai2b-routing-20261105開始前）
    参照記録: .work/sai2b-routing-20261105
    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
    [STM32H7S3_Dev_Board.kicad_pcb]
2026-11-06 旧SAI配線を撤去しSAI2Bを配線
    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
    [STM32H7S3_Dev_Board.kicad_pcb]
2026-11-06 FLASHのクリアランス不足と重複配線端を修正
    参照記録: .work/flash-two-fixes-20261106
    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
    [STM32H7S3_Dev_Board.kicad_pcb]
2026-11-06 一般信号の基本線幅を0.15mmに変更し配線経路を整理
    [STM32H7S3_Dev_Board.kicad_pcb]
2026-11-09 FLASHをU1専用にして配線を調整し、信号ビアを統一
    U10と分岐を撤去し、FLASHの配線長とCLK–IO4間隔を調整する。
    C20・C21をD1側に集め、R2をCSビアの西側へ移す。
    信号ビアを外径0.45 mm・穴径0.20 mmに統一し、保存済みの配線修正を取り込む。
    [STM32H7S3_Dev_Board.kicad_pcb, mcu.kicad_sch]
2026-11-10 PSRAMの配線長と間隔を調整し、設計書を更新
    PSRAMのデータ線を等長化し、クロック周辺とUSART3の配線を整理する。
    配線長、ビア数、DRCの確認結果を設計書に記録する。
    [STM32H7S3_Dev_Board.kicad_pcb]
2026-11-11 MCUの電源デカップリングと信号配線を見直す
    [STM32H7S3_Dev_Board.kicad_pcb, mcu.kicad_sch]
2026-11-11 PSRAMの配線長を再調整し、RMII_TX_ENとの間隔を確保
    [STM32H7S3_Dev_Board.kicad_pcb]
2026-11-11 SDMMC2の等長配線と基板配線を調整
    [STM32H7S3_Dev_Board.kicad_pcb]
2026-11-11 基板の配線クリアランスとシルクを修正しDRCの除外を設定
    [STM32H7S3_Dev_Board.kicad_pcb]
2026-11-11 基板両面のシルクとJ8周辺を調整しDRCの除外を追加
    [STM32H7S3_Dev_Board.kicad_pcb]
2026-11-11 リセットスイッチSW1の配置と基板配線を調整
    [STM32H7S3_Dev_Board.kicad_pcb]
2026-11-11 FLASH_IO5などの基板配線を調整し設計書を更新
    [STM32H7S3_Dev_Board.kicad_pcb]
2026-11-11 PSRAM_IO3の配線長とビア周辺の配線を調整
    [STM32H7S3_Dev_Board.kicad_pcb]
2026-11-11 信号の帰路確保と浮き銅の接地のためGNDビアを5本追加
    [STM32H7S3_Dev_Board.kicad_pcb]
2026-11-11 基板右辺の補強とSDMMC2の帰路確保のためGNDビアを17本追加
    [STM32H7S3_Dev_Board.kicad_pcb]
2026-11-11 Ethernet RMIIの配線とGND帰路を改善
    REF_CLKとADC1_IN0の間隔を広げ、TX_ENと周辺信号を引き直した。
    CRS_DVとTX_ENの層切替付近にGNDビアを配置し、ゾーンを再充填した。
    [STM32H7S3_Dev_Board.kicad_pcb]
2026-11-12 FLASHの等長配線を調整し設計書を更新
    [STM32H7S3_Dev_Board.kicad_pcb]
2026-11-12 Q1の放熱ビアとDVDDゾーンを調整しシルクを整理
    [STM32H7S3_Dev_Board.kicad_pcb]
2026-11-12 U13周辺の電源配線とサーマルビアを改善
    [STM32H7S3_Dev_Board.kicad_pcb]
2026-11-12 ビアとの干渉を避けるため部品番号のシルク位置を調整
    [STM32H7S3_Dev_Board.kicad_pcb]
2026-11-12 基板表面のシルクにφ15 mmの反転ロゴを追加
    [STM32H7S3_Dev_Board.kicad_pcb]
2026-11-12 ティアドロップを追加しQ2・GND配線とシルク配置を調整
    [STM32H7S3_Dev_Board.kicad_pcb]
